Rayawa/WeakSignal/ClawsGo/01_技术审查报告.md

# 《基于 Arduino 嵌入式开发与光杠杆放大的微弱电信号测量》技术审查报告

> 审查对象：论文草稿（2026-07-31 版，docx）
> 审查目的：把论文从"设计方案 + 展望"推进到"物理自洽、有量化支撑、可直接出实验数据"的研究论文
> 审查日期：2026-08-03
> 结论概览：系统总体思路（电磁感应 → 磁电转换 → 光杠杆 → PSD → 数字量化）原理成立、有教学价值；但存在 **4 处必须在实验与定稿前解决的物理/逻辑问题**（含 1 处最核心的频率矛盾）与 6 处中等问题。修复路径见 §6。

---

## 1. 审查方法与判据

本报告按以下判据逐章核查论文：

1. **物理自洽性**：每一级的公式推导是否成立、量纲是否正确、级联后是否闭环；
2. **频带一致性**：信号频率、机械响应带宽、采样率三者是否匹配；
3. **标定闭环性**：标定操作是否覆盖了实际测量路径的全部环节；
4. **完整性**：定量结果（灵敏度、分辨率、噪声底、不确定度）、实验数据、参考文献是否缺失；
5. **先例对照**：是否诚实面对经典检流计/光杠杆先例，创新点表述是否经得起审稿。

每条问题标注**严重 / 中等 / 轻微**三级，并给出对应章节定位与修复方案。

---

## 2. 严重问题（必须修复后才能做实验与定稿）

### C1. 信号源频率与机械响应带宽存在根本矛盾【最核心】

**位置**：第 3 章（发生模块）、第 5 章（偏转模块）、第 6.1.3 节（信号频率测量）、第 7 章（标定）、图 5。

**问题**：

1. **射频源与低频测量的失配**。第 3 章用 Si4713 作为信号源。该芯片是**调频广播发射器，工作频带 76–108 MHz**（[Silicon Labs Si4713 资料](https://www.analog.com/en/products/ad8628.html) 系列说明；[Linux 内核 si4713 驱动文档](https://www.kernel.org/doc/Documentation/devicetree/bindings/media/i2c/si4713.txt)）。它把 100 Hz 音频**调频调制到 ~100 MHz 射频载波**上发射。而接收线圈直接感应的物理量是 **100 MHz 射频磁场**，不是 100 Hz 音频信号——射频感应电流在悬吊偏转线圈里不可能产生 100 Hz 的机械偏转（机械系统对 100 MHz 的平均响应为零，见下条）。论文的测量链路从"发生模块 → 接收线圈"这一级就断了。

2. **机械带宽限制**。即使把低频电流直接注入偏转线圈，悬吊结构也是一个二阶机械振子（等效扭转刚度 $k$、转动惯量 $J$、阻尼 $\zeta$），固有频率 $f_0=\frac{1}{2\pi}\sqrt{k/J}$。对典型参数（$k=10^{-6}\,\text{N·m/rad}$，$J=10^{-7}\,\text{kg·m}^2$），$f_0\approx 0.5\,\text{Hz}$。在 $f \gg f_0$ 时，机械响应幅值按 $(f_0/f)^2$ 衰减——100 Hz 输入下的响应只有共振区的约 $10^{-4}$，完全不可测。**第 6.1.3 节"从 PSD 输出电压周期性反推输入信号频率"与第 5 章图 5 的 100 Hz 生成代码在物理上不自洽**：机械系统无法跟随 100 Hz。

**修复方案（二选一，推荐 A）**：

- **方案 A（推荐）**：把信号源改为**低频磁场源**。由计算机/单片机产生 0.05–0.5 Hz 的正弦电流，驱动一个发射线圈（空芯或磁棒线圈），在接收线圈处产生同频交变磁场。此时整个链路（感应 → 力矩 → 光杠杆 → PSD）工作在**准静态区间**，第 5 章的力矩平衡模型严格成立，第 6.1.3 节的频率测量也成立（测量对象是低频信号的周期）。Si4713 的问题在于：射频方案需要额外的前端解调，与"空间电磁感应 + 直接电流驱动偏转"的主链路不一致。
- **方案 B（保留 Si4713 射频链路）**：必须在接收线圈后增加射频**包络检波/解调**级，恢复出 100 Hz 音频信号后再注入偏转线圈；并明确测量对象变为"解调后的音频信号"而非"场信号"，同时重新解决 100 Hz 与机械带宽的矛盾（仍无法测量 100 Hz 的机械响应，只能测其幅值包络或直流平均）。该方案复杂度高、物理叙事弱，不建议。
- **文档化频带**：无论选哪个方案，都应在第 5 章或第 8 章补一节"机械频率响应与工作频带"，给出二阶传递函数

  $$
  H(s)=\frac{\omega_0^2}{s^2+2\zeta\omega_0 s+\omega_0^2},\qquad
  |H(f)|=\frac{1}{\sqrt{\left[1-(f/f_0)^2\right]^2+\left(2\zeta f/f_0\right)^2}}
  $$

  并明确：幅值测量与频率测量均只在 $f \ll f_0$（建议 $f \le 0.2 f_0$，幅值误差 < 5%）内成立。仿真给出的示例传递函数与工作频带见图（见《03_仿真与数据验证》`fig2_机械频率响应.png`）。

### C2. 标定模型前后不一致：输出量 V 与 P 混用

**位置**：第 6.1 节（$I=C\cdot V+b$）与第 7.1 节（$I=k\cdot P+b$）。

**问题**：第 6.1 节建立"PSD 输出电压 $V$ → 电流 $I$"的线性关系，第 7.1 节又建立"归一化位置算子 $P$ → 电流 $I$"的线性关系，两种输出量混用。PSD 的原始输出是两路电流 $I_1,I_2$，经跨阻放大为两路电压 $V_1,V_2$，真正对位置线性、且**对光强波动不敏感**的量是归一化算子

$$
P=\frac{V_2-V_1}{V_1+V_2}=\frac{2x}{L}
$$

其中 $L$ 为 PSD 有效长度（[Hamamatsu PSD 资料](https://www.alldatasheet.co.nz/datasheet-pdf/pdf/80324/ETC/S3932.html)）。直接用单路电压 $V$ 会同时叠加光强漂移，是错误输出量。

**修复**：全文统一为"**PSD 双路电压 → 归一化算子 $P$ → 位置 $x$ → 电流 $I$ → 电压 $U$/频率 $f$**"的单一条链；$V_1,V_2$ 只作为计算 $P$ 的中间量。标定、仿真、Arduino 程序、第 7 章全部统一为 $I=k\,P+b$（仿真与固件已按此实现）。

### C3. 标定绕过了接收线圈：前级传递函数缺失，系统无法反推"场信号"

**位置**：第 7.1 节（输入电流计算与归一化算子标定）。

**问题**：第 7.1 节标定**直接向偏转线圈注入已知电流**，只覆盖了"电流 → 机械偏转 → 光杠杆 → PSD → 电子"这条**后端链路**；而实际测量路径是"**场信号 → 接收线圈感应 → 偏转线圈**"。标定完全跳过了接收线圈的"场 → 感应电流"转换。后果：即便标定成功，也只能从 PSD 输出反推"偏转线圈电流"，**无法定量反推待测的"场微弱电信号"强度**。第 7.1 节也写明"通过 Arduino 输入已知电流信号"，与第 2 章"测量对象是场中微弱电信号"的定位不匹配。

**修复**：采用**两级标定**：

1. **后级标定（电流 → P）**：向偏转线圈（一体化线圈环路）注入已知电流 $I$，采集 $P$，线性拟合 $I=kP+b$。这步验证"电磁-机械-光学-电子"后端。
2. **前级标定（场 → 电流）**：用已知几何与电流的发射线圈产生已知场 $B_0$（可用公式 $B_0=\dfrac{\mu_0 N_t I_t r_t^2}{2(d^2+r_t^2)^{3/2}}$ 估算），在接收线圈回路串联已知采样电阻 $R_s$，实测感应电流 $I=\dfrac{\mu_{R_s}}{R_s}$，建立"$B_0 \to I$"或"发射电流 $I_t \to I$"的映射，并与理论值 $I=\dfrac{N_1A_1\omega}{Z}B_0$ 互校。

两级标定共同闭合后，才能由一次测量输出"场强 / 等效感应电压 / 电流"任一量。第 7 章需要重写为"后级标定 + 前级标定 + 综合校准 + 线性度验证"四步。

### C4. 扭矩公式缺少几何条件与磁场分布假设

**位置**：第 5 章公式 $M = NIBS = k\theta$。

**问题**：

1. 平面载流线圈在匀强磁场中的力矩为 $\tau = NIAB\sin\varphi$（$\varphi$ 为线圈法线与磁场夹角）。论文略去 $\sin\varphi$，需补充"平衡位置线圈法线 $\perp$ 磁场"的几何条件：此时小角度偏转 $\theta$ 下 $\sin\varphi\approx\cos\theta\approx 1-\theta^2/2$，$\theta\le 5^\circ$ 时非线性项 < 0.4%，与脚注"1% 以内"一致——但必须把这段推导写出来，否则审稿人会追问。
2. 未说明磁场是"近似均匀"还是"D'Arsonval 式辐射磁场"。前者力矩含 $\cos\theta$ 项（二阶非线性），后者力矩与转角无关（线性更优）。建议明确磁场分布假设，并在实验上验证线性度（第 7.3 节正好承担该任务）。

**修复**：改写第 5 章推导为：几何条件 → $\tau=NIAB\cos\theta$ → 力矩平衡 $NIAB\cos\theta=k\theta$ → 小角近似 $x\approx \dfrac{2D}{k}NIAB$（保留 $\cos\theta$ 项作为线性度误差来源分析）。

---

## 3. 中等问题（显著影响论文质量与可信度）

### M1. 系统阻抗 $Z$ 定义错误
**位置**：第 6.1.2 节（$U=I\cdot Z$）。
$Z$ 应为**接收线圈感应电动势驱动整个回路的等效总阻抗** $Z=R_\text{loop}+j\omega L$（接收线圈 + 导线 + 偏转线圈），低频下近似为总直流电阻 $R_\text{loop}$；"由接收线圈自身参数决定"的表述不完整。建议改为：先测回路总电阻 $R$（含采样电阻），给出 $U_\text{emf}=I\cdot R$（准静态）。

### M2. "物理放大不引入噪声"表述过于绝对
**位置**：第 1 章、第 11.2 节。
物理放大确实避免了前置电子放大器噪声，但引入了**机械热噪声**：悬摆的 Brown 运动角噪声 $\theta_n=\sqrt{k_B T/k}$（由涨落-耗散定理决定，与灵敏度共享同一个 $k$）。对 $k=10^{-6}\,\text{N·m/rad}$，$\theta_n\approx 6.4\times10^{-8}\,\text{rad}$，经光杠杆（$2D=2\,\text{m}$）放大为 $x_n\approx0.13\,\mu\text{m}$，等效电流噪声 $\approx 16\,\text{pA}$。这是系统真实的**探测极限下界**，应写进第 8 章误差分析，反而增强论文深度（详见《02_理论模型修正与量化设计》§4）。

### M3. 全文缺少数值设计与灵敏度量级估计
全文没有一组具体的结构/参数数字，无法让读者评估系统性能。应给出：设计参数表（$N_1,A_1,N_2,A_2,B_\text{mag},k,J,D,L,R$）、灵敏度 $x/I=2DN_2A_2B_\text{mag}/k$、满量程电流、分辨率、噪声底、检测极限。仿真与《02_理论模型修正与量化设计》已提供一组自洽示例数字，可直接采用。

### M4. 创新点表述需对照经典先例（镜像检流计）
**位置**：第 11.2 节。
"悬吊线圈 + 反射镜 + 光杠杆读微小电流"正是**镜像检流计（mirror galvanometer）**的原理——开尔文（William Thomson）1858 年为跨大西洋电缆通信发明，动圈式（D'Arsonval）检流计可达 25000 mm/µA@1m 的灵敏度、可测约 $4\times10^{-11}$ A（[镜像检流计历史资料](https://web.archive.org/web/20051215000000/http://en.wikipedia.org/wiki/Mirror_galvanometer)）。因此"基于物理放大的微弱信号检测结构"并非新路径，审稿人一定会指出。建议把创新点**诚实重定位**为：
- 用一维 PSD + 归一化算子替代"灯丝 + 标尺/望远镜"，实现**连续数字读出**与光强波动免疫；
- 用 Arduino + ADS1115 实现**低成本数字化标定与自动量化**（校准参数入 EEPROM）；
- 模块化 + 两级标定方法，使该经典装置成为**可重复、可量化**的本科教学/创新实验平台。
这样的表述既诚实又站得住，且保留了"把经典物理仪器数字化"的真实价值。

### M5. 全文无参考文献
论文需补：器件数据手册（Si4713、AD8628、ADS1115、S3932）、GUM/JJF 1059 不确定度标准、镜像检流计/光杠杆原理、PSD 原理、微弱信号检测方法（锁相放大等）、Arduino 平台。已在《06_参考文献.md》给出可直接使用的清单（含可公开访问的链接）。

### M6. 应用案例章节是"方案"而非"结果"
**位置**：第 9 章。
第 9 章三个子节全部是"可以……可验证……"，无任何数据、图表或对比。修复路径（按顺序）：(a) 先用《03_仿真与数据验证》生成全链路预期结果（已提供）；(b) 按《04_实验验证方案》完成真实实验，用实测数据替换；(c) 至少应补一组"仿真预测 vs 实测"的对照图。

---

## 4. 轻微问题（打磨用）

| # | 位置 | 问题 | 建议 |
|---|---|---|---|
| L1 | 全文 | 摘要/结尾反复出现"提出实验验证方案"，暗示实验未完成 | 定稿前替换为实测结论与数据 |
| L2 | 第 3 章 | 图 5 标注"100 Hz 正弦波生成代码"与系统频带矛盾 | 改为低频信号（0.1–0.5 Hz）或按 C1 处理 |
| L3 | 第 6.1.1 | 截距 $b$ 的物理来源罗列过散（背景光、光路偏移、零点误差） | 分项列明，并在仿真中逐一注入以量化各自贡献 |
| L4 | 第 7.1 | 用 PWM 驱动偏转线圈做标定，开关噪声会污染标定点 | 标定时用 DAC（或 PWM+RC 滤波）+ 延长每点平均时间；固件已提供 MCP4725 方案 |
| L5 | 第 2 章 | "词汇对照表"位于正文之前，不符合期刊/论文惯例 | 移入附录或删除，正文首次出现处加英文括注 |
| L6 | 目录 | 第 6.3 节下"1. 数据转换输出代码"层级编号与目录不一致 | 统一编号 |
| L7 | 第 8.2 | A/B 类不确定度只有文字描述，无分量表与合成公式实例 | 采用《04_实验验证方案》§4 的 GUM 工作表 |

---

## 5. 对标：经典镜像检流计的定量先例

| 指标 | 经典动圈检流计（文献值） | 本系统（仿真设计值，见《02》） |
|---|---|---|
| 电流灵敏度 | ≥ 25000 mm/µA @ 1 m（即 $x/I \ge 2.5\times10^7$ m/A） | 8000 m/A（$N_2A_2B/k$ 参数组） |
| 可测最小电流 | ~ $4\times10^{-11}$ A | 单次 ~ $10^{-10}$ A；长平均 ~ 数十 pA |
| 读出方式 | 灯丝 + 望远镜/标尺（人工读数） | PSD + Arduino 数字读出（自动） |
| 抗光强波动 | 无 | 归一化算子（对光强一阶不敏感） |

> 上表说明：本系统的**灵敏度设计值处于经典检流计同一量级**，这是合理的（原理相同）；而**数字读出、自动标定、抗光强波动**是真实增量。论文第 11.2 节应以此表为骨架重构创新点论述。

---

## 6. 修复路线图（建议执行顺序）

| 步骤 | 内容 | 对应问题 | 产出 |
|---|---|---|---|
| ① | 按《02_理论模型修正与量化设计》重写第 5、6 章的推导与公式 | C4, M1 | 修正稿章节 |
| ② | 更换信号源方案（低频磁场源）并文档化工作频带 | C1 | 第 3 章重写 + 频率响应图 |
| ③ | 统一标定输出量为归一化算子 $P$，建立两级标定流程 | C2, C3 | 第 6、7 章重写 |
| ④ | 运行《03_仿真与数据验证》`sim_system.py`，用生成图/表填充第 7、8、9 章 | M3, M6, M2 | 仿真图 5 张 + 数据表 |
| ⑤ | 按《04_实验验证方案》做真实实验，替换仿真数据 | M6, C3 | 实测数据与图 |
| ⑥ | 按《06_参考文献.md》补齐引文；重构第 11.2 创新点 | M5, M4 | 定稿论文 |

> ⑤ 需要真实装置；①–④、⑥ 中除 M4 外均可在论文层面直接完成。

---

## 7. 结论

论文所描述的"电磁感应 → 磁电转换 → 光杠杆放大 → PSD 数字读出"链路，**原理正确、量级合理**，且与经典镜像检流计的物理先例一脉相承，作为本科创新/教学实验论文有真实价值。但当前版本存在 4 处必须解决的科学一致性问题，其中**信号源频率与机械带宽的矛盾（C1）**是硬伤，必须在实验前修正信号源方案；标定需补上前级（场→电流）环节才能闭环（C3）；输出量需统一到归一化算子（C2）；推导需补几何条件（C4）。完成 §6 的六步修复后，论文可从"设计方案"升级为"有量化模型、有仿真预测、有实验数据、有不确定度评价"的完整研究论文。
