Rayawa/WeakSignal/ClawsGo/02_理论模型修正与量化设计.md

# 理论模型修正与量化设计

> 本文档给出修正后的系统测量模型（含完整推导与几何条件）、一组自洽的设计参数示例、噪声底与检测极限的定量估计。所有数字与《03_仿真与数据验证》中 `sim_system.py` 的默认参数一致，可直接复现。凡与论文草稿不一致之处，以本文档为准（原因见《01_技术审查报告》C1–C4）。

---

## 1. 系统测量链路（修正版）

系统将"场微弱电信号"逐级转换为可数字量化的物理量，完整链路为：

```
发射线圈(B0, f) ──电磁感应──▶ 接收线圈(ε) ──▶ 回路电流 I ──▶ 偏转线圈(N2A2Bmag)
      ▶ 转动力矩 τ ──▶ 悬摆转角 θ ──光杠杆──▶ PSD 光斑位移 x ──▶ 归一化算子 P
      ▶ (kP+b) 反推 I ──▶ (×R) 等效感应电压 U ／ 频率 f
```

**工作区间前提（务必写入论文）**：本模型为**准静态平衡模型**，仅在信号频率 $f$ 远低于悬摆固有频率 $f_0$ 时成立（建议 $f\le0.2f_0$，幅值误差 < 5%）。频率响应见 §5。

---

## 2. 各级方程与推导

### 2.1 前级：电磁感应（场 → 感应电动势）

发射线圈在接收线圈处产生的磁场近似为偶极场。对接收线圈为 $N_1$ 匝、面积 $A_1$、法线与场平行的情况，正弦场 $B(t)=B_0\sin(2\pi f t)$ 产生的感应电动势：

$$
\varepsilon(t)=-\frac{\mathrm{d}\Phi}{\mathrm{d}t}=-N_1 A_1\frac{\mathrm{d}B}{\mathrm{d}t}
=-N_1A_1(2\pi f)B_0\cos(2\pi f t)
$$

幅值：

$$
\varepsilon_0 = N_1 A_1\,\omega B_0,\qquad \omega=2\pi f
$$

回路电流幅值（低频下阻抗近似为总电阻 $R$）：

$$
I_0=\frac{\varepsilon_0}{Z_\text{loop}}\approx\frac{N_1A_1\omega B_0}{R},\qquad
R=R_\text{rx}+R_\text{wire}+R_\text{def}+R_s
$$

其中 $R_s$ 为采样电阻（标定与监测用），$R$ 为**全回路总电阻**（修正 M1：不是仅接收线圈自身）。

### 2.2 中段：力矩平衡（电流 → 转角）

设偏转线圈 $N_2$ 匝、面积 $A_2$、位于磁感应强度 $B_\text{mag}$ 的磁场中，**平衡位置线圈法线与磁场垂直**（几何条件，修正 C4）。载流线圈受到的磁力矩：

$$
\tau_\text{mag}=N_2 I A_2 B_\text{mag}\sin\varphi,\qquad
\varphi=90^\circ-\theta \Rightarrow \sin\varphi=\cos\theta
$$

悬线恢复力矩 $\tau_\text{res}=k\theta$（$k$ 为等效扭转劲度）。平衡：

$$
N_2 I A_2 B_\text{mag}\cos\theta = k\theta
$$

小角度 $\theta\le5^\circ$：$\cos\theta\approx1$，相对误差 $<\theta^2/2\approx0.4\%<1\%$（与论文脚注一致）。故

$$
\theta \approx \frac{N_2 A_2 B_\text{mag}}{k}\,I
$$

**注意**：上式中的 $I$ 是**同一根连续铜线上流经偏转线圈的电流**（接收与偏转一体化线圈，第 2 章已说明），因此 §2.1 的 $I_0$ 与这里的 $I$ 是同一个量——这是整个链路能闭环的关键。

### 2.3 后段：光杠杆（转角 → 光斑位移）

镜面转角 $\theta$，反射光偏转 $2\theta$（反射定律），在距离 $D$ 处的 PSD 面上：

$$
x=2D\tan\theta\approx2D\theta
$$

$\theta=5^\circ$ 时 $\tan\theta-\theta$ 相对误差约 0.25%，可忽略。

### 2.4 PSD 读出（位移 → 归一化算子）

一维 PSD 两电极输出电流 $I_1,I_2$（经 AD8628 跨阻放大为 $V_1,V_2$），光斑距中心位移 $x$：

$$
P=\frac{V_2-V_1}{V_1+V_2}=\frac{I_2-I_1}{I_1+I_2}=\frac{2x}{L}
$$

其中 $L$ 为 PSD 有效长度（[Hamamatsu PSD](https://www.alldatasheet.co.nz/datasheet-pdf/pdf/80324/ETC/S3932.html)）。**$P$ 对光强一阶不敏感**（分子分母同比例缩放），这是选用归一化算子而非单路电压的物理原因。

### 2.5 级联合并：核心转换关系

联立 §2.2–§2.4：

$$
P=\frac{2}{L}\cdot 2D\theta=\frac{4D}{L}\cdot\frac{N_2A_2B_\text{mag}}{k}\,I
$$

即

$$
\boxed{\,I=K\,P\,},\qquad K=\frac{L\,k}{4D\,N_2A_2B_\text{mag}}\ \ [\text{A}]
$$

考虑零偏（光路初始偏移、电路零点、环境背景光），实测模型写为

$$
\boxed{\,I=k_{\scriptscriptstyle IP}\,P+b_{\scriptscriptstyle IP}\,}
$$

**电流灵敏度**（光斑位移对电流的响应）：

$$
S\equiv\frac{\mathrm{d}x}{\mathrm{d}I}=\frac{2D\,N_2A_2B_\text{mag}}{k}\ \ [\text{m/A}]
$$

### 2.6 反推被测物理量

- 感应电流：$I=k_{IP}P+b_{IP}$
- 等效感应电压（电动势幅值）：$U_\text{emf}=I\cdot R$（准静态）
- 场强反推（若发射端参数已知，供前级标定互校）：

$$
B_0=\frac{R}{N_1A_1\omega}\,I
$$

- 频率：仅 $f\le0.2f_0$ 区间内，由 PSD 输出时间序列过零/峰值检测，$f=1/T$（详见 §5 频带限制）。

---

## 3. 设计参数示例与量级估计（可直接写入论文）

以下为一组自洽的示例参数（仿真默认值），物理量量级均接近实物可达到的水平。

### 3.1 设计参数表

| 参数 | 符号 | 取值 | 说明 |
|---|---|---|---|
| 偏转线圈匝数 | $N_2$ | 100 | 漆包铜线，~0.1 mm 线径 |
| 偏转线圈面积 | $A_2$ | $4\times10^{-4}\,\text{m}^2$ | 2 cm × 2 cm |
| 磁铁磁场 | $B_\text{mag}$ | 0.1 T | 钕铁硼磁隙，可 0.05–0.3 T |
| 悬线等效扭转劲度 | $k$ | $10^{-6}\,\text{N·m/rad}$ | 双细铜丝悬吊 |
| 转动惯量 | $J$ | $10^{-7}\,\text{kg·m}^2$ | 线圈+镜组 |
| 光杠杆臂长 | $D$ | 1.0 m | 镜面到 PSD |
| PSD 有效长度 | $L$ | 20 mm | 如 S3932（12 mm）级或自制 |
| 接收线圈 | $N_1, A_1$ | 50 匝, $10^{-4}\,\text{m}^2$ | 1 cm × 1 cm |
| 回路总电阻 | $R$ | 100 Ω | 含接收+导线+偏转+采样 |

### 3.2 计算得到的关键指标

**电流灵敏度**

$$
S=\frac{2D N_2A_2B_\text{mag}}{k}
=\frac{2\times1.0\times100\times4\times10^{-4}\times0.1}{10^{-6}}
=8\times10^{3}\ \text{m/A}
$$

即 **1 µA → 光斑位移 8 mm**；满 PSD 量程（$P=\pm1$，$x=\pm10$ mm）对应电流 $\pm1.25\,\mu\text{A}$。

**转换系数**：$K=\dfrac{L}{2D}\cdot\dfrac{1}{S}=\dfrac{0.02}{2}\times\dfrac{1}{8000}=1.25\times10^{-6}$ A/单位P，即 $I=1.25\times10^{-6}P$（满量程 $P=\pm0.8\leftrightarrow x=\pm8\,\text{mm}\leftrightarrow I=\pm1\,\mu\text{A}$）。

**固有频率与工作频带**

$$
f_0=\frac{1}{2\pi}\sqrt{\frac{k}{J}}=\frac{1}{2\pi}\sqrt{\frac{10^{-6}}{10^{-7}}}=0.50\ \text{Hz}
$$

工作频带 $f\le0.2f_0=0.10\,\text{Hz}$（幅值误差 < 5%）。**这意味着本系统是"准静态"测量装置，不是 100 Hz 信号测量装置**——这是对 C1 的量化支撑。

**前级灵敏度示例**：$B_0=10\,\mu\text{T}$、$f=0.5\,\text{Hz}$ 时（注意 0.5 Hz 已接近 $f_0$，此处仅示意感应级量级）：

$$
\varepsilon_0=N_1A_1\omega B_0=50\times10^{-4}\times\pi\times10^{-5}=1.57\times10^{-7}\,\text{V}
$$

$$
I_0=\varepsilon_0/R=1.57\,\text{nA}\ \Rightarrow\ P=K^{-1}I_0=1.26\times10^{-3}\ \Rightarrow\ x=12.6\,\mu\text{m}
$$

12.6 µm 相对 PSD/读出噪声（~1 µm）约 13 倍，**可测**。$B_0=1\,\mu\text{T}$ 时 SNR≈1.3，处于检测边缘——即该参数组在 0.5 Hz 下的**场强检测极限约为 0.5–1 µT**。

---

## 4. 噪声底与探测极限（第 8 章可用的定量内容）

系统共有四类主要噪声，均折算为**等效输入电流噪声** $i_\text{eq}$。

### 4.1 悬摆 Brown 热噪声（原理性下界）

涨落-耗散定理：悬摆角噪声

$$
\theta_n=\sqrt{\frac{k_B T}{k}},\quad k_B=1.38\times10^{-23}\,\text{J/K},\ T=300\,\text{K}
$$

对 $k=10^{-6}$：$\theta_n=6.4\times10^{-8}\,\text{rad}$。经光杠杆与灵敏度折算：

$$
i_{\text{Brown}}=\frac{2D\theta_n}{S}=\frac{1.28\times10^{-7}}{8000}\approx1.6\times10^{-11}\,\text{A}=16\ \text{pA}
$$

> 这是一个"涨落-耗散"型结论：**灵敏度 $S$ 与热噪声共享同一个 $k$，$S$ 越大（$k$ 越小）热噪声也越大，二者乘积固定为 $2\sqrt{k_B T k}$ 量级**。要提高信噪比只能靠降低机械损耗（品质因数）与延长平均时间，而不是无限减小 $k$。把这点写进论文，误差分析立即有了理论深度。

### 4.2 PSD 与读出电子噪声

- S3932 位置分辨率 0.3 µm（[数据手册](https://www.alldatasheet.co.nz/datasheet-pdf/pdf/80324/ETC/S3932.html)），含跨阻放大后实际取 $x_e\approx1\,\mu\text{m}$（含 AD8628 噪声 0.5 µVpp/0.1–10Hz，[ADI 官网](https://www.analog.com/en/products/ad8628.html)）。

$$
i_{\text{PSD}}=x_e/S=10^{-6}/8000=1.25\times10^{-10}\,\text{A}\approx0.125\ \text{nA}
$$

### 4.3 ADC 量化噪声

ADS1115 16 bit、±4.096 V 量程（[TI 数据手册](https://www.ti.com/product/ADS1115)）。设 $(V_1+V_2)\approx4$ V，则 $P$ 的量化步长约 $2\times(4.096/2^{15})/4\approx1.25\times10^{-4}$，对应位移 $x_q=\dfrac{P_q L}{2}\approx1.25\,\mu\text{m}$：

$$
i_{\text{ADC}}\approx x_q/S\approx1.6\times10^{-10}\,\text{A}\approx0.16\ \text{nA}
$$

### 4.4 回路电阻 Johnson 噪声

回路电阻 $R=100\,\Omega$ 的热电压噪声谱 $\sqrt{4k_B T R}\approx1.3\,\text{nV}/\sqrt{\text{Hz}}$，等效电流噪声：

$$
i_J=\sqrt{4k_B T R\,\Delta f}/R
$$

$\Delta f=1\,\text{Hz}$ 时 $i_J\approx13\,\text{pA}/\sqrt{\text{Hz}}$；若用 $10\,\text{s}$ 平均（$\Delta f\approx0.1\,\text{Hz}$），$i_J\approx4\,\text{pA}$。

### 4.5 合成：检测极限

单次测量（无平均）：主导项为 PSD 与 ADC 噪声，取平方和根：

$$
i_\text{lim}\approx\sqrt{i_{\text{PSD}}^2+i_{\text{ADC}}^2}\approx0.2\ \text{nA}
$$

长平均（$N=100$，约 20 s）：PSD/ADC 白噪声按 $1/\sqrt N$ 下降，热噪声按 $\Delta f$ 下降，量级可到 **数十 pA**。这与经典动圈检流计约 $4\times10^{-11}$ A 的灵敏度同一量级（[镜像检流计资料](https://web.archive.org/web/20051215000000/http://en.wikipedia.org/wiki/Mirror_galvanometer)），说明设计合理、结论可信。

> 诚实表述建议：**本系统单次测量检测极限约 0.2 nA，经长平均可提升到数十 pA**；与经典检流计同量级，优势在数字化与自动化。

---

## 5. 机械频率响应与工作频带

悬摆为二阶振子，传递函数（$\theta$ 对电流 $I$）：

$$
H(s)=\frac{\omega_0^2}{s^2+2\zeta\omega_0 s+\omega_0^2}
$$

幅值响应：

$$
|H(f)|=\frac{1}{\sqrt{\left[1-(f/f_0)^2\right]^2+\left(2\zeta f/f_0\right)^2}}
$$

| 频率 $f$（$f_0=0.5$ Hz） | $|H|$（$\zeta=0.5$） | 说明 |
|---|---|---|
| 0.05 Hz（0.1$f_0$） | 1.00 | 准静态区，可做幅值/频率测量 |
| 0.10 Hz（0.2$f_0$） | 0.98 | 建议工作上限（误差 < 2%） |
| 0.50 Hz（$f_0$） | 1.00（峰值） | 共振，有放大但相位滞后 90° |
| 1.0 Hz（2$f_0$） | 0.33 | 衰减显著 |
| 100 Hz（200$f_0$） | ~$2.5\times10^{-5}$ | **不可测**（C1 的量化依据） |

**对第 6.1.3 节频率测量的修正**：频率测量只在 $f\le0.2f_0$ 内有效；超出此范围应改测幅值包络而非瞬时频率。仿真图 `fig2_机械频率响应.png` 给出了完整 Bode 图与工作区标注。

---

## 6. 两级标定与综合校准（第 7 章重写框架）

### 6.1 后级标定（电流 → $P$）

1. 断开发射端，向一体化线圈回路注入已知电流。用 Arduino + MCP4725(DAC) 或 PWM+RC 滤波产生 $n$ 级直流电平 $I_j$（$j=1..n$），回路串联采样电阻 $R_s$ 实测实际电流 $I_j=U_{R_s,j}/R_s$。
2. 每级稳定后采集 $V_1,V_2$ 计算 $P_j$，每点平均 $N$ 次。
3. 最小二乘拟合 $I=k_{IP}P+b_{IP}$，记录拟合残差、相关系数 $R^2$、线性度。

### 6.2 前级标定（场 → 电流）

1. 发射线圈（$N_t$ 匝、半径 $r_t$）通以已知电流 $I_t$，在距离 $d$ 处（接收线圈中心）产生场

$$
B_0=\frac{\mu_0 N_t I_t r_t^2}{2(d^2+r_t^2)^{3/2}}
$$

2. 对若干组 $I_t$（对应 $B_0$），记录接收回路采样电阻电压 → 实测感应电流 $I_\text{meas}$。
3. 与理论 $I_\text{th}=N_1A_1\omega B_0/R$ 对比，得前级系数 $\eta=I_\text{meas}/I_\text{th}$（含边缘效应、姿态、磁场分布修正）。$\eta\approx1$ 即模型自洽。

### 6.3 综合校准与线性度验证

- 覆盖两组标定的全量程做盲测：设 $I_\text{set}$，测 $P$，反推 $I_\text{meas}$，评估相对偏差与线性度。
- 线性度指标：$\varepsilon_L=\dfrac{\max|I_\text{meas}-(k_{IP}P+b_{IP})|}{\text{FS}}\times100\%$，验收标准建议 < 1%。

---

## 7. 一套可直接写入论文的结果表（仿真已生成）

仿真脚本 `sim_system.py` 会输出并保存：

- 后级标定数据表（$I_j, P_j, u(P_j)$）与拟合结果（$k_{IP}, b_{IP}, R^2$, 线性度）；
- 全链路盲测表（设定场强/电流 vs 实测电流 vs 相对偏差 vs 扩展不确定度）；
- 不确定度预算表（分量、分布、标准不确定度、合成、扩展）；
- 5 张论文用图（校准曲线与残差、线性度、频率响应、噪声与探测极限、全链路时域）。

详见《03_仿真与数据验证》目录下 `sim_system.py` 与 `results/`。
