Rayawa/WeakSignal/ClawsGo/06_参考文献.md

# 参考文献清单（可直接插入论文）

> 论文草稿目前**完全没有参考文献**，这是定稿前的硬伤。以下清单已逐一核实可访问的公开来源，
> 按"器件数据手册 / 原理与先例 / 不确定度标准 / 微弱信号检测方法 / 开发平台"分类，
> 每篇标注：引用格式（GB/T 7714 风格，编号制）、用途、建议插入的章节。标注 ★ 为核心必引。

---

## 一、器件数据手册（支撑第 3、6 章的器件选型论述）

**[1]★ Analog Devices. AD8628/AD8629/AD8630: Zero-Drift, Single-Supply, Rail-to-Rail Input/Output Operational Amplifier（数据手册）[EB/OL]. [2026-07-31]. https://www.analog.com/en/products/ad8628.html**
- 关键参数（引用时可用）：输入失调电压典型 1 µV（最大 5 µV）；输入偏置电流典型 30 pA（最大 100 pA）；增益带宽积 2.5 MHz；0.1–10 Hz 电压噪声 0.5 µVp-p。
- 用途：第 6.2 节"运算放大器选用 AD8628，其低输入偏置电流和低失调电压特性…"处的数据支撑。

**[2]★ Texas Instruments. ADS1115: Ultra-Small, Low-Power, 16-Bit ADC with Internal Reference（数据手册）[EB/OL]. https://www.ti.com/product/ADS1115/part-details/ADS1115IRUGT**（中文版：https://www.ti.com.cn/document-viewer/cn/ADS1115/datasheet/6-ZHCS311D.html）
- 关键参数：16 位 Δ-Σ；数据率 8–860 SPS；可编程增益 ±256 mV–±6.144 V；I²C 接口，4 个可选地址。
- 用途：第 6.2 节"采用独立 ADC 模块…ADS1115 通过 I2C 接口与 Arduino 连接"。

**[3] Silicon Labs. Si4713: FM Transmitter（数据手册，需注册下载）[EB/OL].**
- 说明：Si4713 为 76–108 MHz 调频发射芯片，I²C 控制。其公开驱动文档可见 [Linux 内核 si4713 设备树绑定说明](http://patchwork.ozlabs.org/project/devicetree-bindings/patch/1396785125-8759-3-git-send-email-sre@kernel.org/)。
- 用途：第 3 章信号源设计。**注意**：按《01_技术审查报告》C1，第 3 章需改为低频磁场源方案，此引文用于说明原方案并交代更换原因（射频载波 76–108 MHz 与低频测量链路失配）。

**[4]★ Hamamatsu Photonics. S3932: Position Sensitive Detector（数据手册）[EB/OL]. https://www.alldatasheet.co.nz/datasheet-pdf/pdf/80324/ETC/S3932.html**
- 关键参数：一维 PSD，有效面 1×12 mm，电阻长度 12 mm；位置分辨率 0.3 µm；位置误差典型 60 µm；峰值响应 920 nm；光斑位置公式 (I₂−I₁)/(I₁+I₂) = 2x/L。
- 用途：第 6.1 节"归一化位置算子"公式与 PSD 选型；第 8 章 PSD 位置分辨率不确定度分量（0.3 µm）。

---

## 二、原理与先例（支撑第 1 章引言、第 11.2 节创新点重构）

**[5]★ Mirror galvanometer[EB/OL]. (archive of Wikipedia) https://web.archive.org/web/20051215000000/http://en.wikipedia.org/wiki/Mirror_galvanometer**
- 要点：镜像检流计由开尔文（William Thomson）为跨大西洋电缆通信发明（1858）；动圈式检流计灵敏度可达 25000 mm/µA@1m，可测约 4×10⁻¹¹ A；光杠杆把微小转角放大为远处光斑位移。
- 用途：第 1 章引言把本系统的"悬吊线圈+反射镜+光杠杆"明确放在镜像检流计先例上；第 11.2 节创新点重构时作为对照基准。**这是最不能缺的引文**——否则审稿人会指出创新点表述不诚实。

**[6]★ Meyer G, Amer N M. Novel optical approach to atomic force microscopy[J]. Applied Physics Letters, 1988, 53(12): 1045-1047. DOI: 10.1063/1.100061.**（[AIP 链接](https://pubs.aip.org/aip/apl/article-abstract/53/12/1045/54207/Novel-optical-approach-to-atomic-force-microscopy)）
- 要点：光杠杆作为悬臂偏转检测的标准方法，奠定了现代 AFM 的光学读出基础（诺贝尔奖级应用的支撑技术之一）。
- 用途：第 1 章或第 5 章论证"光杠杆是把微小机械偏转变为可测光斑位移的成熟物理放大手段"。

**[7] Fleming J A. Waves and Ripples in Water, Air, and Aether; Electricity and Magnetism[M].** （经典教材，动圈检流计与光杠杆读数的传统描述，[HathiTrust 在线版](https://babel.hathitrust.org/cgi/ssd?id=mdp.39015002919069;page=ssd;view=plaintext;seq=153;num=137#seq153)）
- 用途（可选）：教学论文里补充经典电磁学教材依据。

---

## 三、不确定度标准（支撑第 8 章）

**[8]★ JCGM 100:2008. Evaluation of measurement data — Guide to the expression of uncertainty in measurement (GUM)[S]. BIPM, 2008.**（[BIPM 官方 PDF](https://www.bipm.org/en/doi/10.59161/JCGM100-2008E)）
- 用途：第 8.2 节 A/B 类评定、合成标准不确定度、扩展不确定度 k=2 的方法依据。

**[9]★ 全国法制计量管理计量技术委员会. JJF 1059.1-2012 测量不确定度评定与表示[S]. 北京: 中国质检出版社, 2012.**（[工标网条目](http://www1.csres.com/detail/231173.html)）
- 用途：中文规范表述（A 类/B 类、包含概率、扩展不确定度取 k=2），与 [8] 二选一或同引。教学/中文论文建议引 [9]，国际规范引 [8]。

---

## 四、微弱信号检测方法（支撑第 1 章引言、第 8 章测量精度提升策略）

**[10]★ Zhang Q, Jeong H, Kang S. Lock-in amplifiers as a platform for weak signal measurements: Development and applications[J]. Current Applied Physics, 2024.**（[ScienceDirect](https://www.sciencedirect.com/science/article/abs/pii/S1567173924001512)）
- 要点：锁相放大是微弱信号测量的主流平台，通过相敏检测与窄带滤波从噪声中提取被淹没信号。
- 用途：第 1 章"传统高增益电子放大同步放大噪声"的对照方法；第 10.3 节"未来可引入更完善的数字滤波、频谱分析"的技术方向。

**[11] Khan M A U, et al. Field-Programmable Gate Array (FPGA)-Based Lock-In Amplifier System with Signal Enhancement: A Comprehensive Review[J]. Sensors, 2025, 25(2): 584.**（[MDPI](https://www.mdpi.com/1424-8220/25/2/584)）
- 用途（可选）：第 11.3 节未来展望（更高性能嵌入式平台的数字锁相方案）。

---

## 五、开发平台

**[12] Arduino. What is Arduino?[EB/OL]. Arduino Documentation. https://docs.arduino.cc/learn/starting-guide/whats-arduino/**
- 用途：第 1 章/第 6 章对 Arduino 开源平台的一处概述引注。

---

## 插入位置速查表

| 引用 | 建议插入章节 | 一句话用法 |
|---|---|---|
| [5]★ | 1、11.2 | 本系统是镜像检流计先例的数字化改造 |
| [6] | 1、5 | 光杠杆是成熟的物理放大手段（AFM 光学读出） |
| [4]★ | 6.1、8 | PSD 归一化公式与位置分辨率误差分量 |
| [1] | 6.2 | AD8628 低偏置低失调参数依据 |
| [2] | 6.2 | ADS1115 16 位高精度 ADC 依据 |
| [3] | 3 | 说明原 Si4713 射频方案（并交代更换原因） |
| [8]/[9]★ | 8.2 | 不确定度 GUM/JJF 方法依据 |
| [10] | 1、10.3 | 锁相放大对比与未来方向 |
| [11] | 11.3 | 未来数字锁相/更高性能平台 |
| [12] | 1、6 | Arduino 平台概述 |

> 引文格式统一按 GB/T 7714—2015 编号制。文末列"参考文献"，正文按出现顺序用 [1][2]…上标标注。
