Rayawa/WeakSignal/ClawsGo/summary.md

# 仿真结果汇总（sim_system.py 一键生成）

## 设计指标
- 电流灵敏度 S = 8e+03 m/A（1 µA → 8.0 mm）
- 转换系数 K_IP = 1.25e-06 A/单位P
- 固有频率 f0 = 0.503 Hz；工作频带上限 f_band = 0.101 Hz
- 满量程电流（|P|≤0.8）= 1.00 µA

## 后级标定
- 拟合斜率 k = 1.250e-06 A/单位P，截距 b = -2.499e-08 A
- R² = 1.000000，线性度 = 0.008%（满量程相对最大偏差）

## 盲测（f=0.1 Hz，平均 40 s）
- 平均后位置噪声 ≈ 0.04 µm
- 对应电流检测极限 ≈ 4.5 pA
- 扩展不确定度（k=2）≈ 5.3%（相对，~满量程计）

## 噪声与探测极限
- 最优平均时间 ≈ 8 s，该处合成噪声 ≈ 13.4 pA
- 单次采样白噪声等效电流 ≈ 200.1 pA
- Brown 热噪声（长平均 40 s）≈ 1.1 pA

## GUM 不确定度
- 合成标准不确定度 u_c = 2.65%（相对）
- 扩展不确定度 U = 5.29%（相对, k=2）

> 说明：以上为示例参数下的理论预测，用于支撑论文第 7/8/9 章的量化论述与
> 实验预期值；实测数据应按照《04_实验验证方案》采集后替换。
