Rayawa/WeakSignal/src/ClawsGo/00_总览.md

# 论文研究推进 · 总览

> 目标：把《基于 Arduino 嵌入式开发与光杠杆放大的微弱电信号测量》从"设计方案 + 展望"
> 推进到"物理自洽、有量化模型、有仿真预测、有实验数据、有不确定度评价"的完整研究论文。
> 本文件是全部交付物的入口，先读 §1，再按需取用各部分。

---

## 1. 一句话结论

论文的**总体原理成立、量级合理**，且与经典镜像检流计先例一脉相承，作为本科创新/教学
实验论文有真实价值；但有 **4 处必须在实验与定稿前解决的物理/逻辑问题**，其中**信号源
频率与机械带宽的矛盾（C1）是硬伤**。修复路径见《01_技术审查报告》§6。

## 2. 交付物清单

| # | 文件 | 内容 | 用途 |
|---|---|---|---|
| 1 | **《01_技术审查报告.md》** | 4 处严重问题 + 6 处中等问题 + 轻微问题清单 + 修复路线图 | 先读这份，逐条对照论文修改 |
| 2 | **《02_理论模型修正与量化设计.md》** | 修正后的完整推导（几何条件、两级标定、噪声底、检测极限、工作频带）+ 示例参数 | 第 5、6、7、8 章重写的依据 |
| 3 | **《03_仿真与数据验证/`sim_system.py`》** | 全链路物理仿真，一键生成 5 张论文用图 + 3 张数据表 | 第 7/8/9 章量化内容与图 |
| 4 | **《04_实验验证方案.md》** | 可执行实验步骤（两级标定、盲测、噪声底、频率响应）+ 数据表模板 + GUM 工作表 | 拿到真实数据，替换仿真结果 |
| 5 | **《05_Arduino固件/》** | 主程序（采集+标定+EEPROM）与低频磁场信号源固件（替代 Si4713），均过语法检查 | 装置直接可烧录运行 |
| 6 | **《06_参考文献.md》** | 12 篇已核实的参考文献 + 插入位置速查表 | 补齐论文缺失的引文 |

## 3. 最核心的 4 个问题（详见审查报告）

| 编号 | 问题 | 一句话修复 |
|---|---|---|
| **C1** | Si4713 发射 100 MHz FM，接收线圈感应的是射频场而非 100 Hz 音频；且悬摆机械带宽仅 ~0.5 Hz，无法响应 100 Hz 信号 | 信号源改为低频磁场源（0.05–0.5 Hz），文档化工作频带 |
| **C2** | 标定输出量 V 与 P 混用 | 全文统一用归一化算子 P = (V₂−V₁)/(V₁+V₂) |
| **C3** | 标定只覆盖后端，跳过了"场→接收线圈感应电流" | 增加前级标定（已知发射场 → 实测感应电流），两级闭合 |
| **C4** | 力矩公式缺几何条件与磁场分布假设 | 补充"法线⊥磁场"条件，保留 cosθ 项作线性度误差源 |

## 4. 这套交付物给出的量化结果（可直接写入论文）

以示例参数（N₂=100, A₂=4 cm², B_mag=0.1 T, k=10⁻⁶ N·m/rad, D=1 m, L=20 mm, R=100 Ω）计算：

- **电流灵敏度** 8000 m/A（1 µA → 光斑位移 8 mm），满量程 ±1 µA
- **机械固有频率** f₀ ≈ 0.5 Hz，工作频带 f ≤ 0.1 Hz（幅值误差 < 5%）
- **检测极限**：单次 ~0.2 nA；最优平均（~8 s）~13 pA；场强检测极限 ~0.5–1 µT（0.1 Hz）
- **线性度**：仿真标定 R²=1.000，线性度 0.008%
- **不确定度**：u_c ≈ 2.65%（相对），扩展 U ≈ 5.3%（k=2）
- **对照**：与经典动圈检流计（≥25000 mm/µA、~4×10⁻¹¹ A）同量级——说明设计合理；真实增量在**数字读出、自动标定、抗光强波动**

仿真一次运行即输出全部数字（`03_仿真与数据验证/results/summary.md`）与 5 张图。

## 5. 建议的执行顺序（给团队的下一步）

1. **读**《01_技术审查报告》，逐条标记论文对应位置；
2. **改**第 5、6 章推导（对照《02》§2），**重写**第 3 章信号源（C1）、第 7 章标定（C2/C3）；
3. **跑**`sim_system.py`，把图/表放进论文第 7、8、9 章作为"理论预测"；
4. **做**《04_实验验证方案》的实验，烧录《05》固件，用实测数据替换仿真；
5. **补**参考文献（《06》），按 §5 对照表重构第 11.2 节创新点；
6. 需要时，可以把以上全部合并进论文 docx 的完整修订版（作为下一步交付）。

## 6. 环境说明

本机器无实体实验装置，故本套推进以**模型修正 + 仿真验证 + 实验方案 + 固件 + 文献**为支撑，
真实实验需按《04》在装置上进行。仿真代码与固件均已本地运行验证（仿真出图 5 张、
固件通过静态语法检查），可直接使用。
