Rayawa/WeakSignal/src/ClawsGo/04_实验验证方案.md

# 实验验证方案（可执行版）

> 本方案把论文第 7、8、9 章"提出实验验证方案"的表述落地为**可照做的实验步骤**，含器件清单、装配要点、两级标定流程、盲测、噪声底与频率响应测试、数据表格模板与 GUM 不确定度工作表。数值预期来自《03_仿真与数据验证》（示例参数），实测数据应填入并替换。
>
> **核心前提（必须先落实）**：按《01_技术审查报告》C1 修复信号源——发射端应产生**低频（0.05–0.5 Hz）交变磁场**，而不是 Si4713 的 100 MHz FM 射频。本方案默认该前提已成立。

---

## 1. 器件与材料清单

| 类别 | 器件 | 说明 |
|---|---|---|
| 信号源 | 低频发射线圈（空芯/磁棒，$N_t\approx50$ 匝、半径 $r_t\approx2$ cm） | 由音频/Arduino 驱动，产生交变磁场 |
| 驱动 | 音频功放（~1 W）或 Arduino + MCP4725(DAC) + 电流缓冲 | 驱动发射线圈 |
| 接收 | 接收线圈（$N_1=50$ 匝、1 cm×1 cm）+ 钕铁硼磁铁 | 场→感应电流 |
| 偏转 | 偏转线圈（$N_2=100$ 匝、2 cm×2 cm）+ 反射镜 + 悬吊双丝 | 一体化连续铜线连接接收线圈 |
| 光学 | 激光器（650 nm, <1 mW）+ 一维 PSD（如 Hamamatsu S3932，12 mm 有效长度）+ 反射镜 | 光杠杆 |
| 电子 | AD8628 ×2（跨阻）+ ADS1115 ×1（16bit, I2C）+ Arduino UNO | 数据采集 |
| 标定 | 精密采样电阻 $R_s=10\,\Omega$（0.1%）、数字万用表 | 电流监测 |
| 环境 | 金属屏蔽罩、减振平台、防风罩、温度计 | 降低环境干扰 |

> 若只做"后级标定 + 系统量化"（论文第 7、8 章的核心），第 1、2 行器件可暂缓——标定直接向偏转线圈注入已知电流即可。

---

## 2. 实验前准备

1. **装配检查**：一体化线圈（接收→偏转）为同一根连续铜线；悬吊双丝自然垂直，反射镜面与激光入射方向成 ~45°，无输入时激光光斑位于 PSD 中心（调 PSD 位置使 $P\approx0$）。
2. **电气检查**：测量回路总电阻 $R$（万用表），记录。用示波器确认 PSD 两路输出随光斑移动反向变化。
3. **零点**：遮光后记录两路电压（暗背景），用于背景扣除。
4. **参数登记表**（写入论文附录/数据页）：$N_1, A_1, N_2, A_2, D, L, R, B_\text{mag}$（用霍尔计或特斯拉计实测）、$k$（见 §3.3）。

---

## 3. 两级标定（对应论文第 7 章重写）

### 3.1 后级标定：电流 → 归一化算子 $P$

1. 断开发射端，用 MCP4725(DAC) 或 PWM+RC 滤波向一体化线圈注入直流电流，串联 $R_s$ 采样电阻实测电流 $I=U_{R_s}/R_s$。
2. 注入 9 级电流：$0,\ \pm0.25,\ \pm0.5,\ \pm0.75,\ \pm1.0\ \mu\text{A}$。每级稳定（>5 s，约 10 倍机械响应时间）后，采集 40 s，算平均 $P$ 与标准差。
3. 最小二乘拟合 $I=k_{IP}P+b_{IP}$，记录 $R^2$、残差、线性度。**验收：$R^2>0.999$，线性度 < 1%**（对照仿真：R²=1.000、线性度 0.008%）。
4. 把 $k_{IP}, b_{IP}$ 写入 Arduino EEPROM（固件已实现 `saveCalib()`）。

**数据表模板**

| 设定电流 $I$ (µA) | 采样电阻电压 $U_{R_s}$ (mV) | 实测电流 $I$ (µA) | $P$ 均值 | $P$ 标准差 | 残差 (nA) |
|---|---|---|---|---|---|
| −1.0 | | | | | |
| … | | | | | |
| +1.0 | | | | | |

### 3.2 前级标定：场强 → 感应电流

1. 发射线圈通以已知低频电流（$f=0.1$ Hz），由几何估算接收线圈处场强

$$
B_0=\frac{\mu_0 N_t I_t r_t^2}{2(d^2+r_t^2)^{3/2}}
$$

2. 对 $I_t$ 取 5 级，记录采样电阻电压 → 实测感应电流 $I_\text{meas}$。
3. 对比理论值 $I_\text{th}=N_1A_1(2\pi f)B_0/R$，得前级系数 $\eta=I_\text{meas}/I_\text{th}$。**$\eta$ 应 ≈ 1（0.8–1.2 内可接受）**，偏差用于修正模型（边缘效应、姿态、磁场分布）。

### 3.3 扭转刚度 $k$ 的独立测定（可选）

在偏转线圈上施加已知重力矩或已知电流矩，测转角与力矩关系斜率得 $k$；或用自由衰减法：给悬摆一个初始偏转，记录角振动周期 $T$，由 $k=J(2\pi/T)^2$ 反推（$J$ 由摆法/几何估算）。该方法与光杠杆标定交叉验证。

---

## 4. GUM 不确定度工作表（对应论文第 8 章）

测量模型 $I=\dfrac{L\,k}{4D N_2 A_2 B_\text{mag}}\,P$。相对不确定度合成：

$$
u_c=\sqrt{\sum_i c_i^2 u_i^2},\qquad U=k_\text{ext}\,u_c\quad(k_\text{ext}=2)
$$

**空白工作表（按 JJF 1059.1-2012 格式）**

| 分量 | 分布 | 半宽/值 | 标准不确定度 $u_i$ | 灵敏系数 $c_i$ | $|c_i|u_i$（相对） |
|---|---|---|---|---|---|
| A 类：重复性 | 正态 | 实测 $s/\sqrt n$ | | 1 | |
| PSD 分辨率 | 矩形 | 0.3 µm → 位置 | | $L/2$ 换算 | |
| ADC 量化 | 矩形 | 1 LSB | | | |
| 臂长 $D$ | 矩形 | ±1% | | −1 | |
| 扭转刚度 $k$ | 正态 | ±2% | | +1 | |
| 磁场 $B_\text{mag}$ | 矩形 | ±2% | | −1 | |
| 面积 $A_2$ | 矩形 | ±1% | | −1 | |
| 温度漂移 | 矩形 | ±1% | | 1 | |
| **合成 $u_c$** | | | | | **≈ 3%（相对）** |
| **扩展 $U$ (k=2)** | | | | | **≈ 5–6%（相对）** |

> 仿真给出的量级：$u_c\approx2.65\%$，$U\approx5.3\%$（k=2），即满量程 1 µA 处 ±53 nA。实测时按上表填入真实分量即可。报告格式：**"$I=(1.000\pm0.053)\,\mu\text{A}$，$k=2$，相对扩展不确定度 5.3%"**。

---

## 5. 性能测试（对应论文第 8、9 章）

### 5.1 线性度验证
用 §3.1 数据画 $I$–$P$ 响应曲线与拟合残差，判定线性范围。**验收：在 ±1 µA 内相对偏差 < 1%**。

### 5.2 重复性与零点漂移
零输入下连续采集 30 min，记录 $P$ 的时间序列，给出：
- 短期重复性（1 min 内标准差）；
- 零点漂移（30 min 内 $P$ 变化换算成电流）；
- 若漂移超阈值（如 1 pA/s 等效），检查温度与机械蠕变。

### 5.3 噪声底与探测极限
逐步减小输入场强，记录 SNR=1 对应的场强/电流即为检测极限。对照仿真：单次 ~0.2 nA、长平均（~40 s）~数十 pA；场强检测极限 ~0.5–1 µT（0.1 Hz 下）。**实测值应在此量级附近**，差异大则检查噪声屏蔽与机械振动。

### 5.4 频率响应
对偏转线圈注入不同频率（0.02–5 Hz）等幅电流，测输出幅值衰减，画出 $|H(f)|$，标出实测 $f_0$ 与工作频带（$f\le0.2f_0$）。**对照仿真 fig2**：$f_0\approx0.5$ Hz（取决于 $k,J$）。这一步直接验证 C1 的修复效果。

### 5.5 抗光强波动验证（归一化算子优势）
保持光斑位置不变，用中性密度片改变激光强度 ±20%，记录 $V_1,V_2$ 与 $P$ 的变化。**预期：$P$ 变化远小于单路电压变化**（对照：单路电压随光强线性变化，$P$ 一阶不变）。

---

## 6. 应用案例实验（对应论文第 9 章，二选一先做）

### 6.1 光电效应/光电流检测
光电管（或太阳能电池/光电二极管）输出端接入系统输入端（替代接收线圈，直接注入偏转线圈）。改变入射光强，测输出电流。预期：光电流随光强近似线性（线性区）。**数据表**：光强 → 输出电流 → 相对不确定度。

### 6.2 低频弱磁场/弱信号场探测
用发射线圈在距离 $d$ 处产生已知弱场，测系统反推场强 vs 设定场强，画偏差曲线。预期符合 §5.3 的检测极限。

---

## 7. 安全与注意事项

- 激光 < 1 mW，避免直射眼睛；实验加遮光罩。
- 悬吊丝细而脆，操作轻缓；屏蔽罩接地。
- 强磁铁远离电子器件与手机/磁卡。
- 所有信号线用屏蔽线，单点接地，避免地环路。
- 每次实验记录环境温度与振动情况（日志表）。

---

## 8. 数据交付清单（写入论文附录）

- [ ] 参数登记表（§2.4）
- [ ] 后级标定数据表 + 拟合结果图（fig1 模板）
- [ ] 前级标定表 + $\eta$ 值
- [ ] 盲测表（设定 vs 实测 vs $U$）
- [ ] 频率响应数据 + 图（fig2 模板）
- [ ] 噪声底数据 + 图（fig3 模板）
- [ ] 不确定度工作表（§4）
- [ ] 应用案例数据（§6）
