Rayawa/WeakSignal/src/ClawsGo/demo_分析报告.md

# 实验数据分析报告

## 装置参数（本次分析所用）

| 参数 | 值 | 参数 | 值 |
|---|---|---|---|
| D = 1 | L = 0.02 | R_loop = 100 | Bmag = 0.1 | k = 1e-06 | N2 = 100 | A2 = 0.0004 | zeta = 0.3 |

## 数据概览
- 数据行 2500，标定点 9，测量段 9。
- 标定斜率 k = 1.250428e-06 A/unitP（设计 1.250000e-06，偏差 +0.03%），R² = 0.999977，线性度 0.575%。
- 噪声窗口单次 σ(I) = 186.54 pA；最优平均 6 s 后 σ(I) ≈ 21.73 pA；单次 3σ 探测极限 ≈ 559.62 pA。
- 频率响应实测点：0.05Hz:1.00，0.10Hz:1.02，0.20Hz:1.13，0.30Hz:1.35，0.50Hz:1.66，1.00Hz:0.31（理论 $f_0$=0.50 Hz，工作频带 ≤ 0.10 Hz）。
- 盲测偏差：
  - 段7：真实 500.0 nA，测量 500.2 nA，偏差 +0.04%
- GUM 合成标准不确定度 u_c = 2.62%，扩展 U = 5.24%（k=2）。

> 数据与脚本：analyze_data.py 自动生成。
