Rayawa/WeakSignal/src/ClawsGo/summary (1).md

# 仿真结果汇总（参数组：lab_variant）

## 装置参数
| 参数 | 参数 |
|---|---|
| 接收线圈匝数 = 40 匝 | 接收线圈面积 = 9e-05 m² |
| 偏转线圈匝数 = 80 匝 | 偏转线圈面积 = 0.00032 m² |
| 偏转区磁感应强度 = 0.08 T | 悬线等效扭转劲度 = 1.4e-06 N·m/rad |
| 偏转组转动惯量 = 1.2e-07 kg·m² | 光杠杆臂长 = 0.9 m |
| PSD 有效长度 = 0.012 m | 回路总电阻 = 120 Ω |
| 机械阻尼比 = 0.35 — |

## 设计指标
- 电流灵敏度 S = 2.63e+03 m/A（1 µA → 2.6 mm）
- 转换系数 K_IP = 2.28e-06 A/单位P
- 固有频率 f0 = 0.544 Hz；工作频带上限 f_band = 0.109 Hz
- 满量程电流（|P|≤0.8）= 1.82 µA

## 后级标定
- 拟合斜率 k = 2.279e-06 A/单位P，截距 b = -7.591e-08 A
- R² = 1.000000，线性度 = 0.025%

## 盲测（f=0.1 Hz，平均 40 s）
- 平均后位置噪声 ≈ 0.04 µm
- 对应电流检测极限 ≈ 13.6 pA
- 扩展不确定度（k=2）≈ 5.3%

## 噪声与探测极限
- 最优平均时间 ≈ 11 s，该处合成噪声 ≈ 28.7 pA
- 单次采样白噪声等效电流 ≈ 607.9 pA
- Brown 热噪声（长平均 40 s）≈ 2.7 pA

## GUM 不确定度
- 合成标准不确定度 u_c = 2.65%
- 扩展不确定度 U = 5.29%（相对, k=2）

> 由 sim_system.py 一键生成。结果输出至 results/lab_variant/，图件输出至 figs_lab_variant/。
