Rayawa/WeakSignal/.trae/documents/微弱电信号测量文档全面重写计划.md

# 微弱电信号测量论文全面重写计划

## 一、重写范围

基于用户明确的四模块新方案，对 DOCX 文档全文（第2章至第11章 + 中英文摘要）进行重新撰写。保留封面（logo、校徽、题目、学院、班级、姓名、日期）。保留原文档中的图片引用（接线图、原理图、立体/平面示意图、预算饼状图等）。原文档文字仅作参考，新方案以四个模块为组织框架。

## 二、新方案四模块架构

| 模块 | 名称 | 核心组成 | 功能 |
|---|---|---|---|
| 模块一 | 微弱电信号发生模块 | Arduino UNO + Si4713 调频发射芯片 + 天线 | 产生可控频率、功率的标定电磁信号 |
| 模块二 | 信号接收模块 | 200匝小线圈 + 左右强磁铁（匀强磁场） | 电磁波感应 → 感应电流产生 |
| 模块三 | 偏转与光杠杆读出模块 | 大圆形线圈 + 反射镜 + 配重 + 双悬线 + 激光 + PSD | 感应电流驱动线圈偏转 → 光杠杆放大 → PSD 读出 |
| 模块四 | 数据处理模块 | AD8628 + ADS1115 + Arduino UNO + OLED / 串口 | 跨阻放大、ADC 采集、归一化算法、串口输出 |

**信号流**：Si4713发射天线 → 接收线圈感应 → 感应电流 → 双悬线传导 → 大线圈(匀强磁场)偏转 → 反射镜偏转 → 激光偏折 → PSD输出 → AD8628跨阻放大 → ADS1115采集 → Arduino运算 → 串口打印 / OLED显示

## 三、文档章节重写方案

### 摘要与关键词（中英文）— 重写

中文摘要应反映四模块架构和完整信号流：
- 围绕微弱电信号测量问题，设计基于 Arduino 的四模块测量系统
- 信号发生模块（Si4713 可控调频发射）、信号接收模块（200 匝线圈感应）、偏转与光杠杆读出模块（大线圈+悬线+激光+PSD）、数据处理模块（AD8628+ADS1115+Arduino）
- 信号链路：Si4713 发射 → 接收线圈感应 → 感应电流 → 大线圈匀强磁场偏转 → 反射镜偏转 → 光杠杆放大 → PSD 位移检测
  
关键词扩充：Arduino；微弱电信号；Si4713；双线圈；光杠杆；PSD 传感器

英文摘要同步更新。

### 第2章 系统总体设计 — 重写

#### 2.1 系统架构

按四模块重写：

**模块一：信号发生模块**
- Arduino UNO 作为控制器，通过 I2C 接口控制 Si4713 FM 调频发射芯片
- Si4713 可编程设置发射频率（76–108MHz，10kHz 步进）和发射功率
- 支持单频点发射、扫频发射、音频调制发射三种工作模式
- 发射天线采用小型 PCB 环形天线或偶极子天线

**模块二：信号接收模块**
- 200 匝小型接收线圈，左右对称放置一对高性能永磁体构建匀强磁场
- 待测电磁波穿过接收线圈产生感应电动势和感应电流
- 线圈两端通过接线端子连接两根外包绝缘的并排细悬线
- 接收线圈被独立金属网罩包裹屏蔽

**模块三：偏转与光杠杆读出模块**
- 接收线圈感应的电流经双悬线直接流入大圆形线圈
- 大线圈置于另一对永磁体产生的匀强磁场中，通电后受安培力偏转
- 大线圈中心粘贴微型高反射率平面镜，随线圈同步转动
- 框架一端固定激光笔，发射准直光束经反射镜反射至另一端 PSD
- 光杠杆原理：镜面偏转角 θ → 反射光偏转 2θ → PSD 上光斑位移 x

**模块四：数据处理模块**
- PSD 输出两路光电流 → AD8628 跨阻放大器 → 电压信号
- ADS1115 16 位 ADC 采集 → Arduino UNO 处理
- 归一化算子 P = (V2-V1)/(V2+V1) 消除光强波动
- 串口输出 + OLED 实时显示

#### 2.2 电路设计 — 小幅重写

保留原电路接线图和原理图引用。文字更新为：
- 电路分为两部分：信号发射端电路和信号接收/处理端电路
- 发射端：Arduino → I2C → Si4713 → 天线
- 接收/处理端：PSD → AD8628 → ADS1115 → Arduino → OLED/串口
- 电源：9V 电池为 UNO 和发射模块供电

### 第3章 硬件设计与实现 — 重写

按新方案的四个模块拆分为四节（替代原有的以"采集/放大/处理"划分的结构）：

#### 3.1 信号发生模块设计（NEW — 替代原数据采集模块前半部分）

完整描述 Arduino + Si4713 + 天线：
- Si4713 芯片规格和工作原理（I2C 控制、频率寄存器、功率寄存器）
- Arduino 与 Si4713 的硬件连接（SDA/SCL/VCC/GND/ANT）
- 天线设计（偶极子天线长度计算 λ/4 或 PCB 环形天线）
- 发射模式控制：单频点标定模式、扫频测试模式
- 发射功率和频率的软件控制方法

#### 3.2 信号接收模块设计（NEW — 替代原数据采集模块中间部分）

完整描述 200 匝接收线圈 + 永磁体 + 屏蔽：
- 线圈参数：200 匝、线径、骨架尺寸
- 永磁体配置：N-S 相对放置，磁极间距、磁场均匀性
- 法拉第电磁感应定律：ε = -N·dΦ/dt
- 独立金属网罩屏蔽结构
- 接线端子与悬线的电气连接方式

#### 3.3 偏转与光杠杆读出模块设计（NEW — 替代原数据采集模块后半部分）

完整描述大线圈+悬线+反射镜+磁铁+激光+PSD：
- 双悬线结构：两根直径 0.02–0.05mm 磷青铜丝并排、外包绝缘
- 大圆形线圈：轻质非磁性骨架绕制，中心粘贴反射镜，下方加配重
- 磁场系统：左右永磁体构建均匀恒定磁场
- 安培力偏转原理：磁力矩 M = N·I·B·S
- 双线恢复力矩：M_res = k_eq·θ
- 光杠杆：θ = x/(2D)
- PSD 传感器安装（精密滑轨）、激光笔固定
- 光路对准和初始标定方法
- 力学模型和量化公式：

$$\varepsilon = -N_1\frac{d\Phi}{dt}, \quad I = \frac{\varepsilon}{R_{total}}$$
$$M_{mag} = N_2 I B S_2, \quad M_{res} = k_{eq}\theta$$
$$I = \frac{k_{eq}}{2 D N_2 B S_2} \cdot x$$
$$U = I \cdot Z$$

#### 3.4 数据处理模块设计

保留 AD8628 + ADS1115 + Arduino 的完整描述（内容不变，但章节归属调整）。归一化算子 P 和算法公式保持不变。

#### 3.5 电磁屏蔽与抗干扰设计

保留已扩展的五层屏蔽体系描述。

#### 3.6 电源选择

保留不变。

### 第4章 系统标定与量化模型 — 保留（已修改达标）

当前版本的双线等效劲度系数标定、信号量化模型、机械谐振选频分析均已是新方案的术语，保留不变。

### 第5章 软件系统设计 — 小幅重写

#### 5.1 数据换算算法
- 保留原有归一化算子算法
- 新增：Si4713 发射控制伪代码（频率/功率设置、扫频循环）
- 信号流注释更新为四模块路径

#### 5.2 数字降噪算法 — 保留
#### 5.3 显示界面设计 — 保留（扩展为"显示与串口输出"）

### 第6章 实验预算分析 — 小幅修改

更新预算表结构以反映四模块划分（当前已有信号发射模块行，需确认是否正确反映 Si4713 成本）。

### 第7章 系统校准与性能测试 — 小幅重写

#### 7.1 校准方法

保留已修改的 Si4713 描述。强调：
- Arduino 控制 Si4713 以已知频率和功率发射标定信号
- 接收线圈感应 → 大线圈偏转 → PSD 位移输出
- 改变发射功率/频率，记录位移响应曲线
- 扫频模式自动测绘频率响应

#### 7.2 线性度验证 — 保留
#### 7.3 稳定性测试 — 保留

### 第8章 误差分析与不确定度评估 — 保留（已达标）

### 第9章 应用案例与效果分析 — 小幅重写

各节文本中更新为：
- "发射端 Arduino+Si4713 以固定频率..."
- "接收线圈感应后经悬线传导至偏转线圈..."
- 强调四模块完整闭环

### 第10章 系统局限性讨论 — 保留（已达标）

### 第11章 结论与展望 — 小幅重写

11.1 研究结论：
- 重写为四模块架构总结
- "接收线圈-悬线-大线圈-反射镜分离式力学放大结构"
- "Arduino+Si4713 可控发射与 Arduino+ADS1115 接收处理形成完整嵌入式闭环"

11.2 研究创新点：
- 保留"力-光-电多级级联检测"创新点
- 新增"基于 Si4713 的可控扫频发射"作为信号源创新
- 保留归一化算子 P 的算法创新

11.3 未来展望 — 保留

## 四、执行约束

- **保留内容**：封面（logo、校徽、题目、学院、班级、姓名）、所有图片引用（接线图、原理图、立体/平面示意图、预算饼状图）
- **电路部分**：AD8628、ADS1115、Arduino UNO、OLED 的选型和描述完整保留
- **TikZ 示意图**：`2-2 装置平面示意图工程文件.tex` 当前已是新方案版本，保留
- **CPP 代码**：`4-1 数字换算算法程序.cpp`、`4-2 数字降噪算法程序.cpp` 保留；新增 `4-3 信号发射控制程序.cpp`（Si4713 控制代码）

## 五、执行方式

由于修改范围覆盖了文档正文的绝大部分（摘要 + 第2–11章），采用以下策略：

1. 解包当前 DOCX → 获取 XML
2. 保留封面部分 XML（从开头到第2章标题之前的所有 XML 节点）
3. 第2章起用 Python 批量重写正文 XML（替换各章节段落内容）
4. 最后更新摘要段落（封面之后的摘要部分）
5. 重新打包 DOCX
6. 用 LibreOffice 导出 PDF

## 六、假设与决策

1. 四模块命名采用用户指定的四个名称
2. 接收线圈 200 匝（用户明确给出）
3. Si4713 作为信号源用于标定和测试，在第 3.1 作为独立硬件模块描述
4. 大线圈匝数和尺寸保留原文档的 N 和 S 符号
5. 电路（AD8628 + ADS1115 + Arduino）的详细描述完整保留
6. 五层电磁屏蔽描述保留
7. 保留所有现有图片资源和引用关系
8. 串口输出替代/补充 OLED 显示，体现"打印在串口"这个用户要求
