Rayawa/WeakSignal/.trae/documents/微弱电信号测量装置改造计划.md

# 微弱电信号测量装置改造计划

## 一、改造概要

将原"悬丝-单线圈-光杠杆"方案改造为**"接收线圈-悬线-大线圈-光杠杆"分离式方案**，并增加双层电磁屏蔽（整体金属网罩 + 接收线圈独立屏蔽）。需要修改的文件包括：

- `基于Arduino嵌入式开发的微弱电信号测量.docx` — 论文正文全文修改
- `2-2 装置平面示意图工程文件.tex` — TikZ 示意图重新绘制
- `基于Arduino嵌入式开发的微弱电信号测量.pdf` — 重新导出

---

## 二、核心原则

> **电路部分（AD8628 跨阻放大器 + ADS1115 ADC + Arduino UNO + OLED）完全不变。**
> 原方案的 PSD → AD8628 → ADS1115 → UNO → OLED 整条电学链路保持原样。
> 变化**仅发生在物理/机械前端**：原来单个矩形线圈同时承担"接收电磁波"和"产生偏转"两个功能，新方案将这两个功能分离到两个独立的线圈。

## 三、新旧方案核心差异对照

| 维度 | 原方案 | 新方案 |
|---|---|---|
| 信号接收 | 单个矩形线圈既是接收体也是偏转体 | 上方200匝接收线圈独立感应电磁信号 |
| 偏转机构 | 矩形线圈+悬丝+镜子 | 圆形大线圈+镜子，由两根并排细线悬挂 |
| 电流传导 | 在线圈内部直接流通 | 从上方接收线圈经两根并排绝缘细线流入下方大线圈 |
| 框架结构 | 开放式重型支架 | 长方体固定框架，两端分别固定激光笔和PSD |
| 电磁屏蔽 | 三层屏蔽（法拉第笼+铝合金屏蔽盒+BNC） | 在三层屏蔽基础上增加整体金属网罩笼罩整个框架 + 接收线圈独立金属网罩 |
| 悬丝/悬线 | 单根悬丝（既是力学支撑又是电流通路） | 两根并排细线（正负分开、外包绝缘），既是悬挂又是电流通路 |
| 磁铁布置 | 大线圈左右各一对永磁体 | 上方接收线圈左右各有磁铁 + 下方大线圈左右各有磁铁 |
| 电路部分 | PSD → AD8628 → ADS1115 → UNO → OLED | **完全不变** |

---

## 四、逐章修改方案（按原文档章节顺序）

### 4.0 总体说明

文档 11 章 + 摘要中，涉及物理机械前端的章节需要不同程度修改，涉及电路和软件的章节基本不变。以下按"不改 / 小幅修改 / 重写"三级标注每节。

---

### 4.1 封面 — 不改

题目、学院、姓名、日期不变。

---

### 4.2 摘要与关键词 — 小幅修改

**中文摘要**：将"系统利用悬丝结构与光杠杆原理"改为"系统利用悬线悬挂式双线圈结构与光杠杆原理"；将"悬丝-线圈-反射镜一体化力学放大结构"改为"接收线圈-悬线-大线圈-反射镜分离式力学放大结构"。

**英文摘要**：同步更新对应英文表述。

**关键词**：保持"跨阻放大器"（电路未变），新增"金属网罩"、"双线圈"。

---

### 4.3 第1章 引言 — 小幅修改

当前末尾段落提到"通过悬丝结构实现力学放大"——改为描述双线圈分离设计的工程动机：接收端与偏转端解耦后可独立优化各自的灵敏度、匝数和噪声特性。增加一两句电磁屏蔽必要性论述。

---

### 4.4 第2章 系统总体设计

#### 2.1 系统架构 — 重写

原方案四个模块（数据采集、数据放大、数据处理、显示输出）扩展为五个模块：

1. **信号接收模块**（NEW — 独立为一节）：200匝小型接收线圈，左右各置永磁体。待测交变电磁波穿过接收线圈产生感应电流。接收线圈被独立金属网罩包裹屏蔽。通过接线端子将正负极分别连接到两根悬线。

2. **电流传导与力学偏转模块**（重写 — 替代原"数据采集模块"的开头部分）：接收线圈输出的感应电流通过两根并排、外包绝缘的细悬线向下传导，流入悬挂于长方体框架中央的圆形大线圈。大线圈在永磁体均匀磁场中受安培力偏转，带动反射镜同步转动。两根悬线并排走线，既是电流通路也是扭转回复弹簧。

3. **光杠杆读出与信号探测模块**（保持但改写前半段）：激光笔固定于长方体框架一端，PSD固定于另一端。光路不变。PSD 利用横向光电效应将光斑位置转化为两路光电流，**随后送入 AD8628 跨阻放大器转为电压信号**——此处不变。

4. **信号处理模块**（保持）：ADS1115 + Arduino UNO + OLED 完全不变。

5. **电磁屏蔽模块**（NEW）：在原有三层屏蔽（法拉第笼铜网 + BNC屏蔽线 + 铝合金屏蔽盒）基础上，增加整体金属网罩笼罩长方体框架 + 接收线圈独立金属网罩，形成五层屏蔽体系。

#### 2.2 电路设计 — 保持

**完全不变。** PSD → AD8628 跨阻放大器 → ADS1115 ADC → Arduino UNO → OLED 的整条电学链路、接线图和原理图均不变。唯一注意：原理图中标注"光电检测器 → 跨阻放大器"这段是 PSD 到 AD8628 的路径，保持原样。

---

### 4.5 第3章 硬件设计与实现

#### 3.1 数据采集模块设计 — 完全重写

这是改动最大的章节。原方案描述"单个矩形线圈+悬丝"共约三页内容，需要全部替换为新的双线圈分离结构。新内容结构：

**a) 长方体固定框架**
- 材质：铝合金型材拼接或亚克力激光切割
- 两端分别固定：一端安装激光笔（光杠杆光源），另一端安装 PSD 传感器（带精密滑轨）
- 顶部横梁用于固定悬线上端

**b) 信号接收子模块（200匝接收线圈）**
- 线径和尺寸建议
- 左右两侧对称放置永磁体（N-S 相对布置，增强线圈区域的磁通密度）
- 线圈输出正负两端通过小型接线端子连接两根悬线
- **独立金属网罩**包裹接收线圈及其磁铁，网罩单点接地

**c) 悬线-大线圈-反射镜子模块**
- 两根直径 0.02~0.05mm 磷青铜丝（或钨丝），并排走线，间距极小
- 线外包绝缘漆层或细塑料管，防止正负线短路
- 上端固定于框架顶部横梁的两个相邻锚点，下端分别焊接于大线圈的正负引线端
- 大线圈为圆形，轻质非磁性骨架（如薄塑料环）绕制
- 骨架中心粘贴微型高反射率平面镜（与前文镜子规格一致）
- 大线圈下方加挂配重块，降低重心、增加稳定性

**d) 磁场系统**
- 上方接收线圈：左右各一对永磁体（与前文规格一致）
- 下方大线圈：左右各一对永磁体（比上方更大，以适应大线圈尺寸），构建均匀恒定磁场区

**e) 光杠杆光路**
- 与前文一致：激光 → 反射镜 → PSD

**f) 整体电磁屏蔽**
- 整体金属网罩笼罩整个长方体框架，网罩框架接地
- 接收线圈独立屏蔽：在整体网罩内部，接收线圈区域额外包裹小型金属网罩
- 定性分析双层屏蔽必要性

#### 3.2 数据放大模块设计 — 保持

**完全不变。** AD8628 跨阻放大器的选型理由、偏置电流、零漂移特性等全部保留。此节内容是 PSD 输出光电流 → 电压转换，与新方案的机械前端改动无关。

#### 3.3 数据处理模块设计 — 保持

**完全不变。** ADS1115 + Arduino UNO 的结构、I2C 通信、归一化算子 P 的公式 `P = (V2-V1)/(V2+V1)`、增益量程选择等全部保留。

#### 3.4 电磁屏蔽设计 — 大幅扩展

原方案已有三层屏蔽（法拉第笼铜网 + BNC屏蔽线 + 铝合金屏蔽盒）。新方案在此基础上扩展为五层：

1. **整体金属网罩**（NEW — 第四层）：笼罩整个长方体框架。材质铜网或不锈钢网。网孔密度选择兼顾屏蔽效能与通风/可视性。网罩与系统地单点接地，隔离空间电磁辐射对悬线和大线圈的直接干扰。

2. **接收线圈独立屏蔽**（NEW — 第五层）：小型金属网罩单独包裹200匝接收线圈及其磁铁，独立接地。信号链路的最前端若有噪声混入，后续各级均无法消除。

3. **屏蔽效能定性分析**：简述金属网罩对电磁波的反射损耗和吸收损耗机理，定性说明双层网罩的级联衰减效果。

4. **原三层屏蔽**（保持）：法拉第笼铜网、BNC屏蔽线缆、铝合金屏蔽盒的描述保留不变。

#### 3.5 电源选择 — 保持

**完全不变。** 9V电池为放大模块供电、UNO 5V为 ADS1115 和 OLED 供电——这些与机械前端改动无关。

---

### 4.6 第4章 系统标定与量化模型

#### 4.1 悬丝扭转劲度系数 k 的静态标定 — 小幅修改

- 术语："悬丝" → "悬线"
- 补充说明：两根悬线并联，等效扭转劲度系数 k_eq = k₁ + k₂ ≈ 2k（假设两线材质和尺寸相同）
- 标定方法（静态力矩平衡法+砝码）不变

#### 4.2 信号量化模型与反推算法 — 小幅修改

原公式 `I = k·x / (2·D·N·B·S)` 在形式上保持不变（最终反推公式形式相同）。但需要在推导过程中补充说明：
- N 和 S 是大线圈（偏转线圈）的匝数和面积，而非接收线圈的
- 接收线圈的200匝决定了感应电流的大小，但反推公式中直接通过位移 x 反算电流 I，不涉及接收线圈参数
- 因此**最终公式不变**，只需在物理建模描述中将 k 写为 k_eq（双线等效劲度系数）

#### 4.3 机械谐振选频特性分析 — 小幅修改

- k → k_eq（双线等效劲度系数）
- J 为大线圈+反射镜+配重的转动惯量（原方案为矩形线圈+镜子+配重）
- 谐振频率公式 f₀ = (1/2π)·√(k_eq/J) 形式不变
- 新增定性讨论：200匝接收线圈的电感可能与悬线-大线圈回路形成额外的电学谐振，可作为一种补充选频机制

---

### 4.7 第5章 软件系统设计 — 完全不变

5.1 数据换算算法、5.2 数字降噪算法、5.3 显示界面设计全部保留。CPP 代码文件 (`4-1 数字换算算法程序.cpp`、`4-2 数字降噪算法程序.cpp`) 不需修改（电路中 AD8628 和 ADS1115 没变，软件逻辑没变）。

---

### 4.8 第6章 实验预算分析 — 修改

**电路部分成本完全不变**（AD8628 保留）。仅机械/屏蔽部分新增：

- 新增：接收线圈绕制材料（0.1mm漆包线，约￥10）
- 新增：大线圈圆形骨架（轻质塑料环，约￥5）
- 新增：长方体固定框架（铝合金型材，约￥60）
- 新增：整体金属网罩材料（铜网/不锈钢网，约￥40）
- 新增：接收线圈独立屏蔽网罩（小铜网，约￥15）
- 修改："磷青铜悬丝/钨丝" → "磷青铜悬线"（￥12不变，但备注改为"双线"）
- 修改："重型金属支架" → "长方体固定框架"（移至新增项）
- 修改："轻质矩形线圈" → 拆分为"接收线圈 + 大线圈"
- 修改：预算表结构从三个模块扩展为四个模块（新增"信号接收模块"行），饼状图同步更新

---

### 4.9 第7章 系统校准与性能测试 — 小幅修改

- 7.1：将"悬丝扭转劲度系数"改为"悬线等效扭转劲度系数"
- 7.2："磁场非均匀性或悬丝非线性形变" → "磁场非均匀性或悬线非线性形变"
- 7.3："采样频率与悬丝的机械固有频率不匹配" → "采样频率与悬线系统的机械固有频率不匹配"

---

### 4.10 第8章 误差分析与不确定度评估 — 修改

8.1 误差来源新增：
- **悬线不对称误差**：两根悬线长度不等或刚度不对称导致零点偏离、灵敏度偏差
- **网罩磁场微扰**：金属网罩可能对永磁体磁场产生轻微屏蔽效应，大线圈所在区域的 B 值可能略低于预期
- **接触电阻漂移**：接收线圈→悬线→大线圈的四个焊点/接头长期氧化引入的串联电阻变化

8.2 不确定度计算模型 — 保持（公式不变，物理量名称更新）。

8.3 提升策略中：
- "增加透明亚克力防风罩" → "在整体金属网罩外增加亚克力防风罩"
- "在支架底部加装橡胶减震垫" → "在长方体框架底部加装橡胶减震垫"

---

### 4.11 第9章 应用案例与效果分析 — 小幅修改

9.1 光电效应实验中："悬丝式微弱电流测量系统"→"悬线式微弱电流测量系统"；"悬丝-线圈-反射镜一体化"→"接收线圈-悬线-大线圈-反射镜分离式"。

9.2 微弱光探测："固定悬丝参数"→"固定悬线系统参数"。

9.3 材料光电特性测试："悬丝式"→"悬线式"。

---

### 4.12 第10章 系统局限性讨论 — 小幅修改

10.1 性能局限性："机械悬丝的物理特性"→"机械悬线系统的物理特性"；"高灵敏度的扭转悬丝结构"→"高灵敏度的双线扭转悬挂结构"。

10.2 应用局限性："电磁屏蔽与棉花团阻尼"→"五层电磁屏蔽与棉花团阻尼"。

10.3 技术局限性 — 保持（此节讨论 UNO 运算能力和 PSD 热噪声，与机械前端改动无关）。

---

### 4.13 第11章 结论与展望 — 修改

11.1 研究结论："悬丝-线圈-反射镜一体化力学放大结构"→"接收线圈-悬线-大线圈-反射镜分离式力学放大结构"。AD8628 保持原文。

11.2 研究创新点："极细悬丝-轻质线圈-反射镜一体化转动结构"→"极细双悬线-轻质大线圈-反射镜悬挂式转动结构"；"线圈转动惯量与悬丝劲度系数"→"大线圈转动惯量与双线等效劲度系数"。

11.3 未来展望 — 保持。

---

### 4.14 新增：信号发射端改造（Si4713 调频发射模块）

原方案在第7章校准方法中使用**RC 电路**作为标定信号源，产生低频微弱电磁波。新方案替换为 **Arduino + Si4713 调频发射模块**：

**Si4713 简介**：Si4713 是 Silicon Labs 的 FM 调频发射芯片，支持 76–108MHz 频段，通过 I2C 接口由 Arduino 控制频率、发射功率和音频调制。相比 RC 电路的优势：
- **频率精确可控**：可编程设置任意发射频率，精度达 10kHz 步进
- **功率可调**：输出功率 - 可调（最大约 +20dBm，天线匹配后），可控制信号强度用于灵敏度测试
- **带音频调制**：可注入正弦波/方波调制信号，模拟不同类型的电磁波
- **扫频能力**：通过 Arduino 程序可自动扫频，用于测绘系统的频率响应曲线

**在文档中的影响范围**：

**a) 第3章 硬件设计**：新增第 3.6 节"信号发射模块设计"，描述 Arduino（可用独立 UNO 或与主控共用）+ Si4713 + 发射天线的硬件连接。Si4713 通过 I2C 与 Arduino 通信，发射天线可采用小型偶极子天线或 PCB 环形天线。

**b) 第7.1节 校准方法**：将原 RC 电路描述替换为：
- Arduino 控制 Si4713 以已知频率和功率发射标定信号
- 接收线圈感应信号，经悬线→大线圈偏转→PSD 读出
- 改变发射功率或频率，记录对应的位移响应
- 通过多组数据拟合标定系数

**c) 第6章 预算**：新增 Si4713 模块（约￥15–25）和独立 Arduino Nano（约￥20，若不与主控共用）。

**d) 第9.3节**：扫频能力可用于材料光电特性测试中的频率响应分析。

**e) 软件**：新增信号发射控制的 Arduino 代码片段（Si4713 库调用，频率/功率设置）。

---

## 五、辅助文件修改

### 4.1 TikZ 示意图重绘（`2-2 装置平面示意图工程文件.tex`）

现有 TikZ 代码 (53行) 需要完全重绘，新图应包含：

1. 长方体框架外轮廓（虚线表示金属网罩包裹）
2. 顶部：200匝接收线圈 + 左右磁铁 + 小型独立屏蔽网罩（虚线框）
3. 悬线：两根并行细线从顶部接收线圈引出，向下连接大线圈
4. 中央：圆形大线圈 + 反射镜 + 左右磁铁
5. 左端：激光笔（标注"光杠杆"）
6. 右端：PSD传感器
7. 光路：激光 → 反射镜 → PSD（虚线箭头）
8. 整体金属网罩：以虚线矩形框表示笼罩整个框架

### 4.2 PDF 文件

论文修改完成后，使用 LibreOffice 重新导出 PDF 替换。

### 4.3 立体示意图（SolidWorks 工程文件）

`2-1 装置立体示意图工程文件.SLDPRT` 和 `2-1 装置立体示意图导出.png` — 需重新建模导出，但本文档修改计划暂不涉及 3D 建模（需要用户另行提供或授权建模）。

---

## 六、执行顺序

1. 修改 `基于Arduino嵌入式开发的微弱电信号测量.docx`（论文正文），按第3~4章 → 第7~8章 → 第1~2章 → 第9~11章 → 摘要的顺序逐章改写
2. 新增第3.6节"信号发射模块设计"（Arduino + Si4713）
3. 重写第7.1节"校准方法"（RC电路 → Arduino + Si4713 可控发射）
4. 更新第6章预算表（新增 Si4713、框架、屏蔽网罩等）
5. 重新绘制 TikZ 平面示意图（`2-2 装置平面示意图工程文件.tex`）
6. 新增信号发射控制代码片段（Si4713 库调用示例）
7. 用 LibreOffice 重新导出 PDF
8. 更新预算饼状图

---

## 七、假设与决策

1. **接收线圈匝数**：200匝（用户明确给出）
2. **大线圈匝数和尺寸**：文档中未给出精确值，保留原文档中的 N 和 S 符号
3. **金属网罩材质和网孔**：不做具体选型约束，以"铜网或不锈钢网"描述
4. **框架尺寸**：不做硬编码，以 X×Y×Z 变量表示
5. **悬线直径**：建议 0.02~0.05mm 磷青铜丝
6. **AD8628 保留**：电路部分完全不变，PSD → AD8628 → ADS1115 → UNO 链路保持原样
7. **Si4713 发射模块**：作为独立信号源，可由独立 Arduino Nano 控制或与主控 UNO 共用 I2C 总线
8. **SolidWorks 3D 模型**：暂不修改，留待后续
9. **原文档中"三层屏蔽"保留**：新方案在此基础上扩展为五层屏蔽（+整体金属网罩 + 接收线圈独立屏蔽）
