Rayawa/WeakSignal/v1/2-2 装置平面示意图导出.pdf

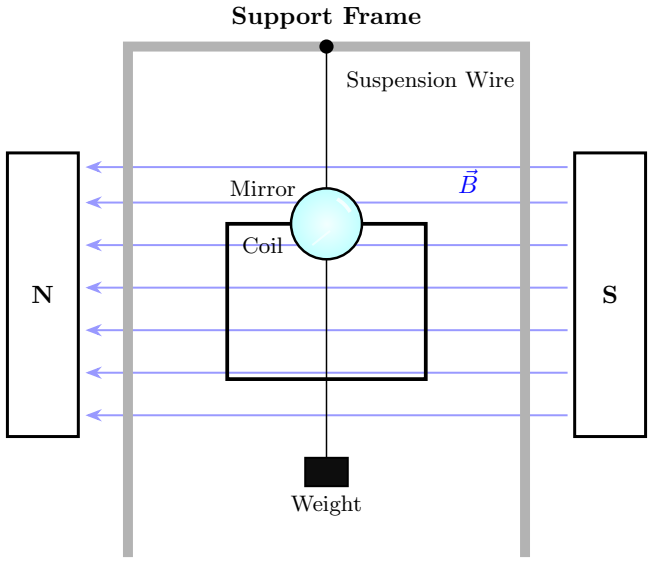
[picture p15: figure]
Support Frame; Suspension Wire; Coil; Mirror; Weight
