Rayawa/WeakSignal/depricated/6 挂载网页说明.txt

本项目论文挂载在以下网页：
https://rayawa.top/projects/signal.html
