Rayawa/WeakSignal/demo/合影1.jpg

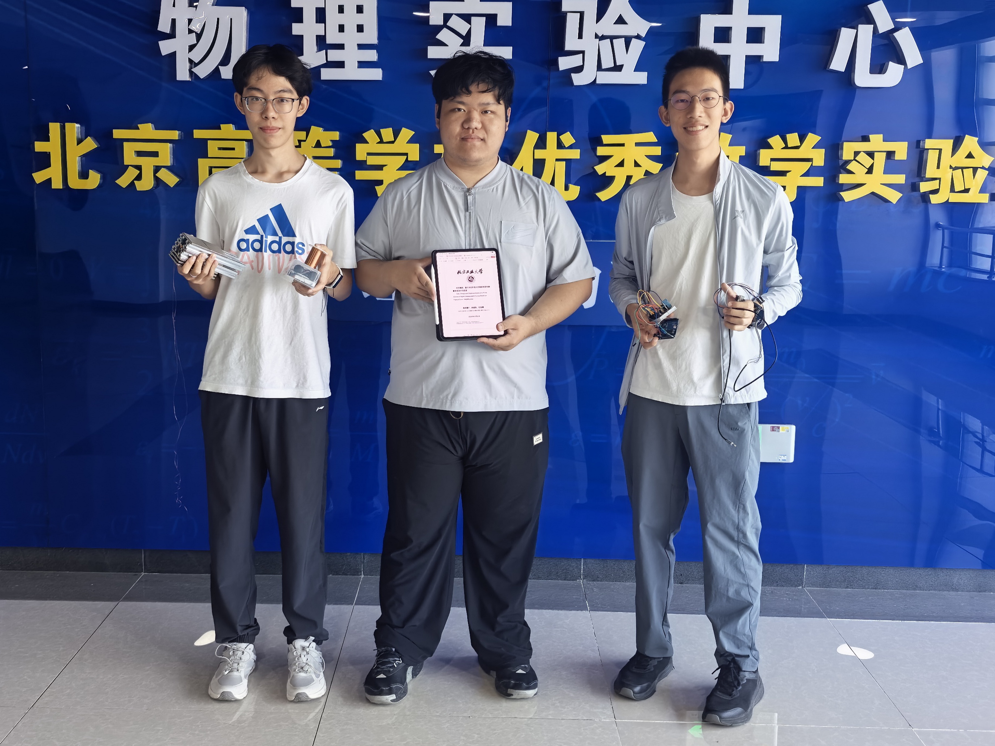
demo/合影1.jpg
