Rayawa/WeakSignal/demo/合影2.jpg

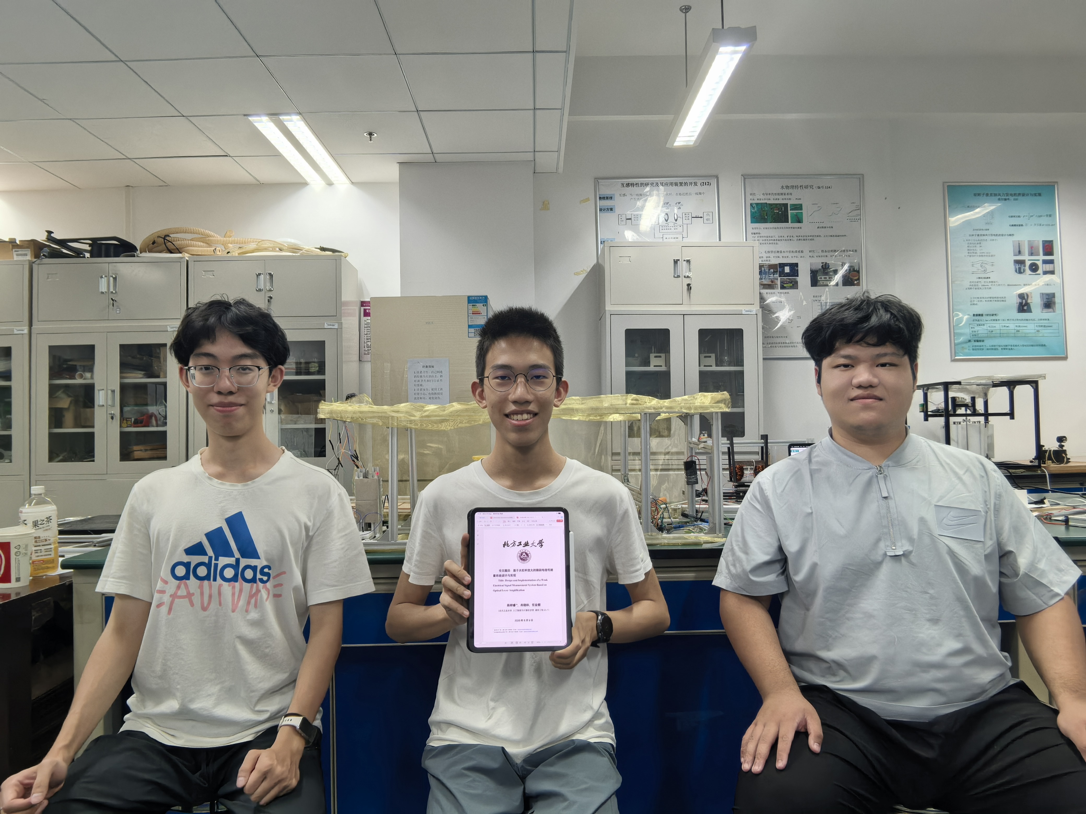
demo/合影2.jpg
