Rayawa/WeakSignal/demo/装置左.JPG

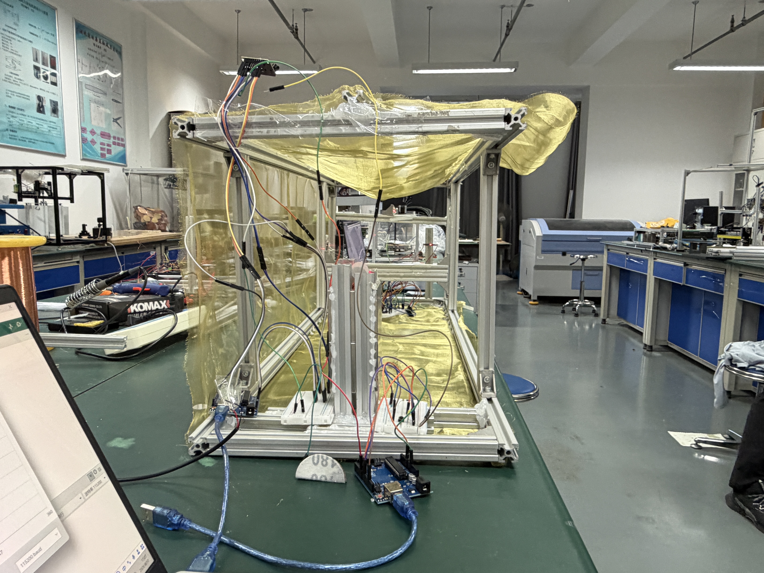
demo/装置左.JPG
