Rayawa/WeakSignal/src/ClawsGo/fig3_噪声与探测极限 (1).png

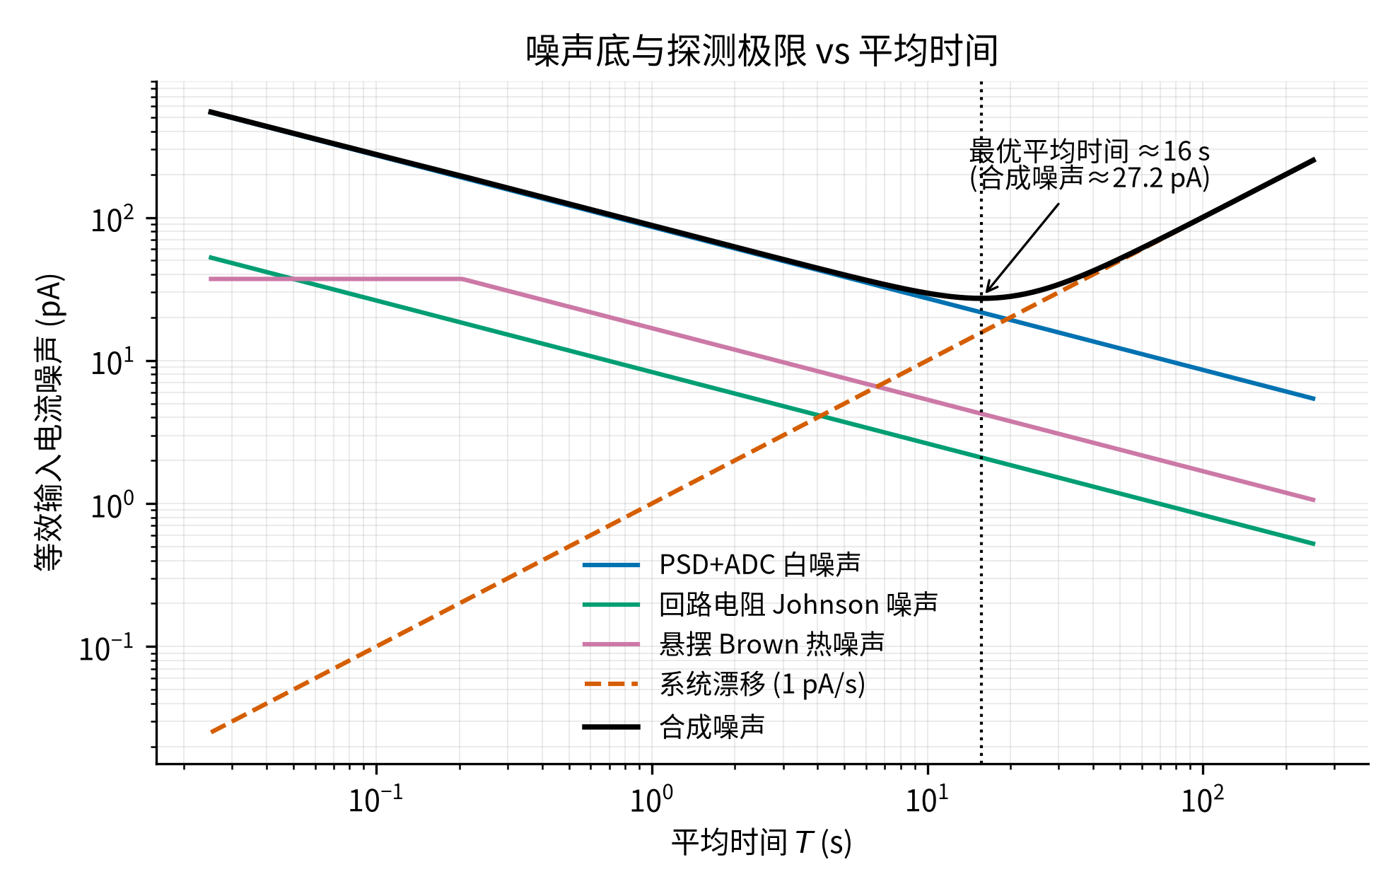
src/ClawsGo/fig3_噪声与探测极限 (1).png
