Rayawa/WeakSignal/src/demo/装置俯视.JPG

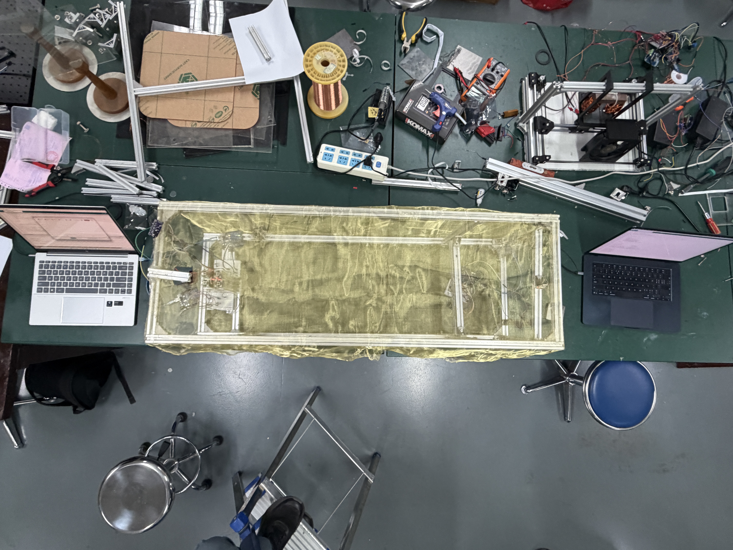
src/demo/装置俯视.JPG
