Rayawa/WeakSignal/src/demo/装置右.JPG

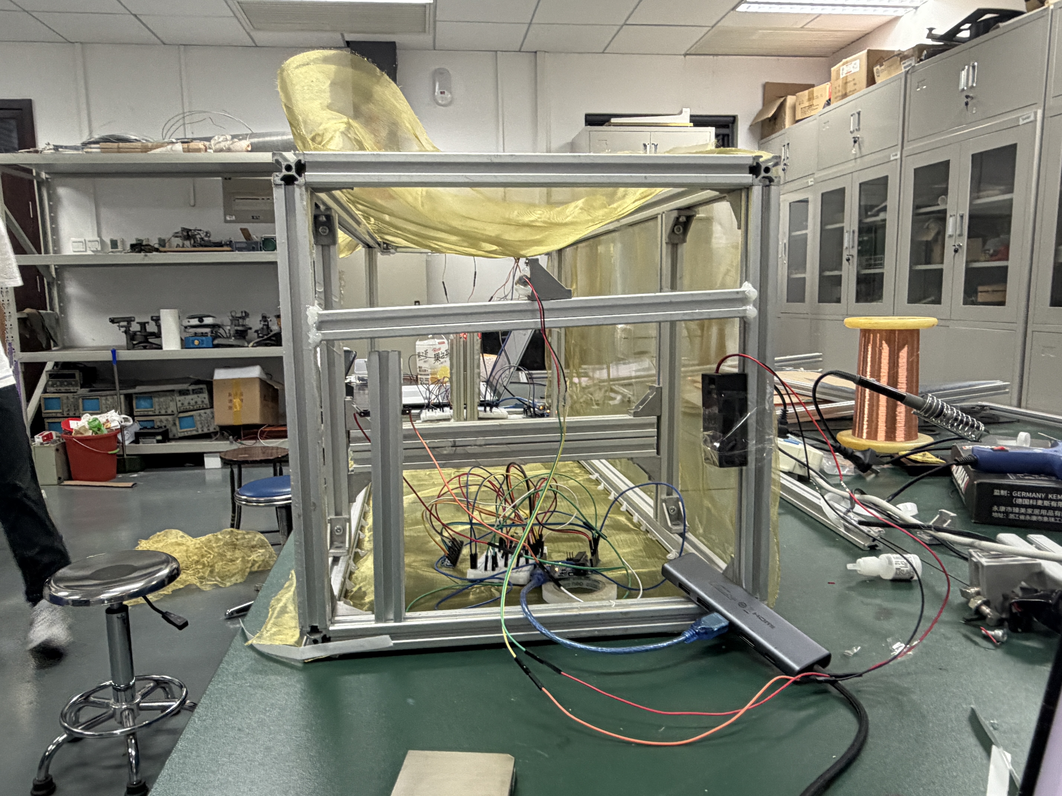
src/demo/装置右.JPG
