Rayawa/WeakSignal/src/demo/装置总览.JPG

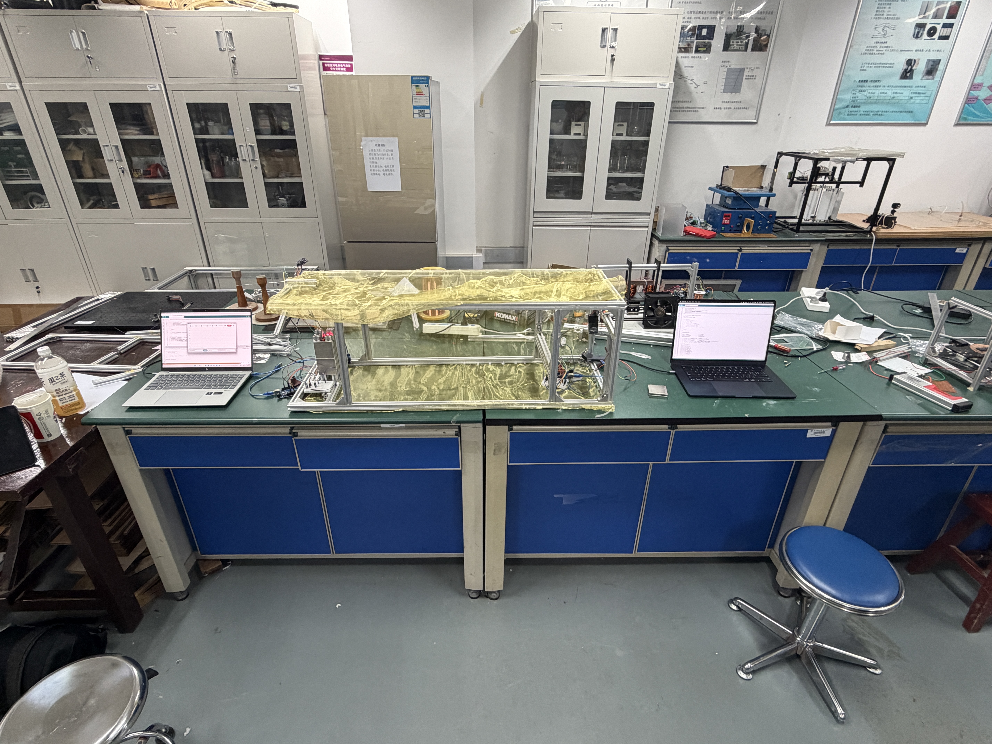
src/demo/装置总览.JPG
