Rayawa/WeakSignal/src/demo/装置正面.JPG

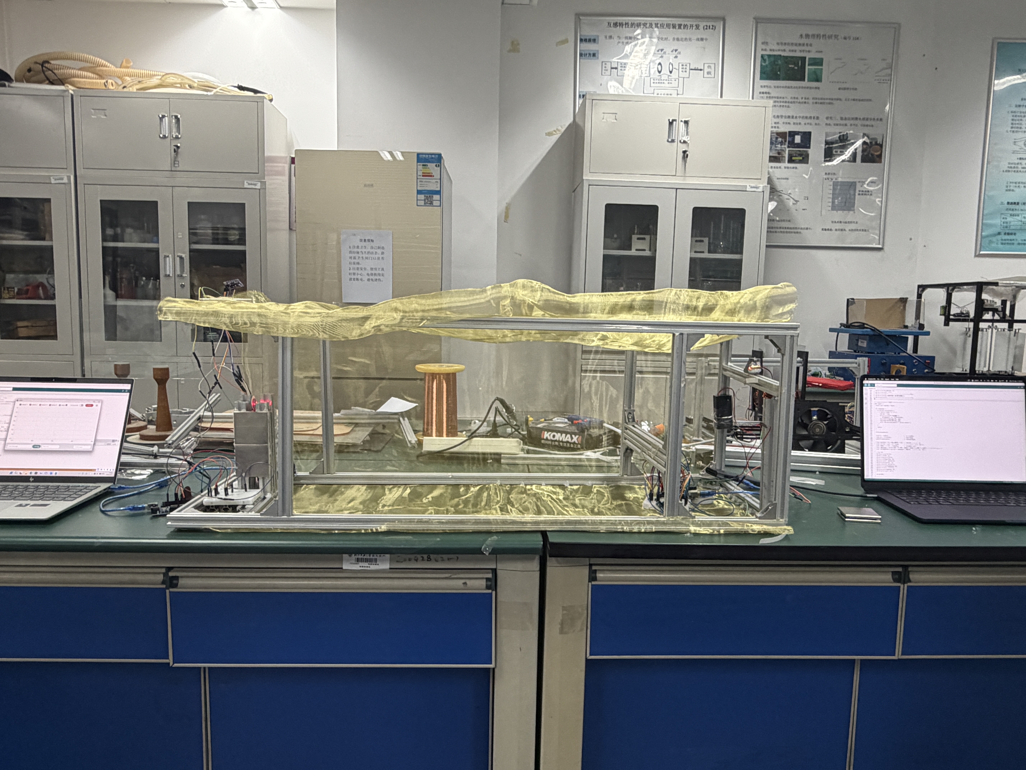
src/demo/装置正面.JPG
