Rayawa/WeakSignal/src/实验器材表.xlsx

需购买实验器材 |  |  |  | 实验室已有实验器材
器件名称 | 数量 | 金额 | 用途与备注 | 器件名称 | 数量 | 用途与备注
0.08mm漆包铜线 | 1卷 | ￥38.00 | 用于接受线圈与偏转线圈 | 长方体铝合金固定框架 | 若干个 | 组合固定实验器材，保持装置稳定
250目黄铜网 | 3片 | ￥57.00 | 用于实验装置的屏蔽 | Arduino UNO | 2个 | 电路模块总控，计算与串口输出
金属屏蔽罩 | 2个 | ￥42.20 | 用于电路模块的屏蔽 | AD8628 | 1个 | 运算放大与跨阻放大
2mm实验镜 | 10片 | ￥8.09 | 反射激光至PSD | 天线 | 1个 | 发出可控微弱电信号
50*50*5mm钕铁硼强磁铁 | 10片 | ￥340.00 | 产生平行匀强磁场 | 面包板 | 2个 | 便捷快速连接电路用
650nm点状激光器 | 1支 | ￥19.85 | 发射激光提供偏转信息 | 杜邦线 | 2卷 | 连接各元件
9V叠层电池 | 1个 | ￥9.82 | 电路模块供电 | 电阻 | 2个 | 保护电路
9V电池供电盒 | 1个 | ￥4.50 | 使电池接入电路，屏蔽电池噪声
Si4713 | 1个 | ￥64.36 | 用于发射微弱电信号
ADS1115 | 1个 | ￥25.64 | 精确测量采集输出的电压
3.5mm耳机线 | 1条 | ￥14.07 | 用于调制100Hz的AM信号
一维PSD位置传感器 | 1个 | ￥350.00 | 接收放大后的偏转信息
