Rayawa/WeakSignal/(list of files, drawings)

Other design files:
fritzing/数据转换模块电路文件.fzz
v1/3 系统电路工程文件.fzz
