Rayawa/WeakSignal/(commit log)

2026-08-09 Coordinate external LED behavior across calibration and measurement
2026-08-10 Connect PSD measurement to Arduino ADC inputs
2026-10-10 chore: 忽略发票目录与 AppleDouble 文件，修复 Fritzing 忽略路径
    - 新增 src/invoices/ 规则：发票含个人信息，严禁入库
    - 新增 ._* 规则：exFAT 卷上 macOS 会大量生成 AppleDouble 文件
    - 修正 fritzing/ -> src/fritzing/：原规则因路径变更已失效
